chris83527/railway/README.md

# railway
Schematics for railway controller
