chris83527/railway/railway_keypad/railway_keypad.png

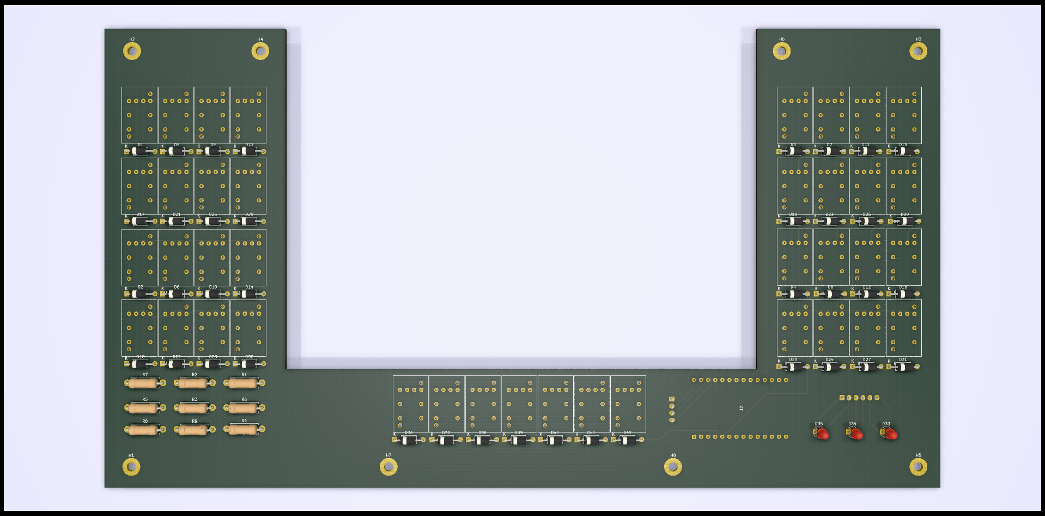
railway_keypad/railway_keypad.png
