chris83527/railway/railway/railway_back_panel2.FCStd

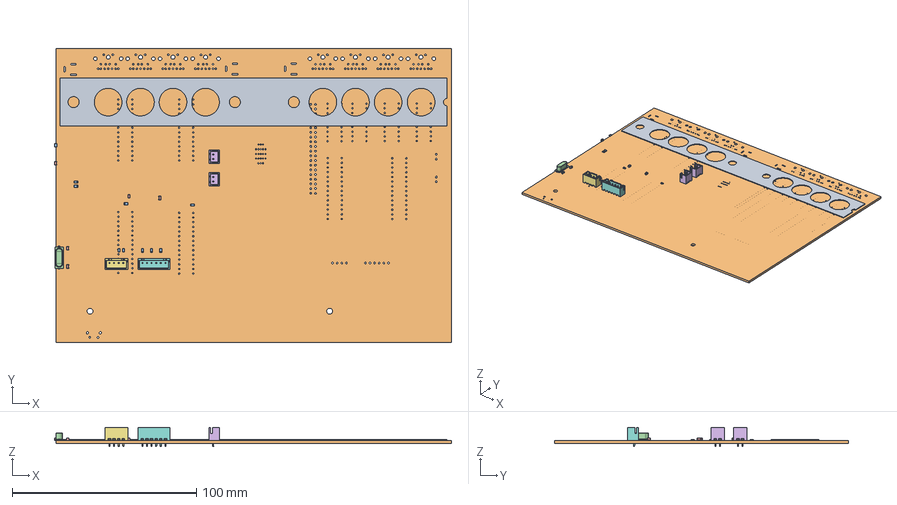
[picture p2: CAD file, 2024-12-26]
railway/railway_back_panel2.FCStd
215.4 x 159.7 x 10.4 mm
Pcb_d347
R20_R_0805_2012Metric_8b4ad0b62f5e x 10
Y1_Crystal_SMD_HC49-SD_456765e1dc0e
C9_C_0805_2012Metric_157590397889 x 5
J3_JST_B2B_XH_A_e3afbfe7dc1d x 2
J5_JST_B4B_XH_A_566c48c3f301
J2_JST_B6B_XH_A_4f16ad57375a
