chris83527/railway/railway/railway_back_panel2-Body.stl

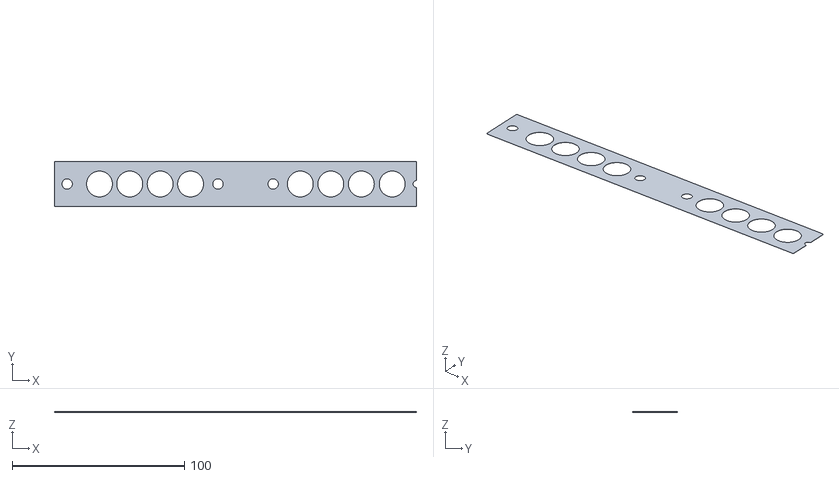
[picture p3: CAD file, 2024-12-26]
railway/railway_back_panel2-Body.stl
210.0 x 26.0 x 0.5
