chris83527/railway/railway/bezel-Body.stl

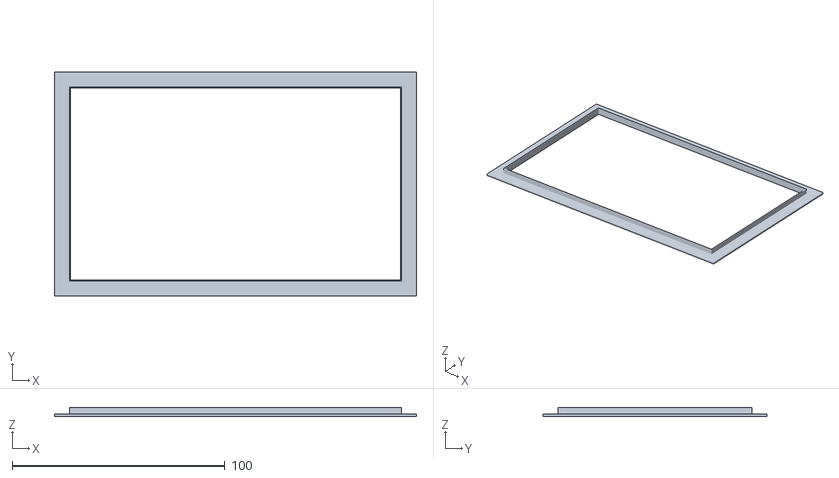
[picture p4: CAD file, 2024-12-26]
railway/bezel-Body.stl
170.0 x 105.0 x 4.00
