chris83527/railway/railway/button-Body.stl

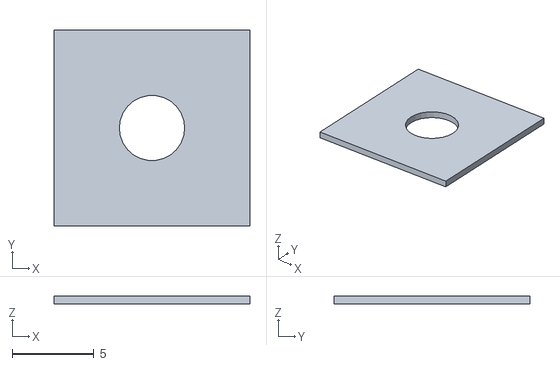
[picture p5: CAD file, 2024-12-26]
railway/button-Body.stl
12.0 x 12.0 x 0.5
