chris83527/railway/(list of files, cad)

Other CAD files:
railway/bezel.FCStd
railway/button.FCStd
