chris83527/railway/railway/plots/railway__Assembly.pdf

1 | 2 | 3 | 4 | 5 | 6 | 7 | 8

A

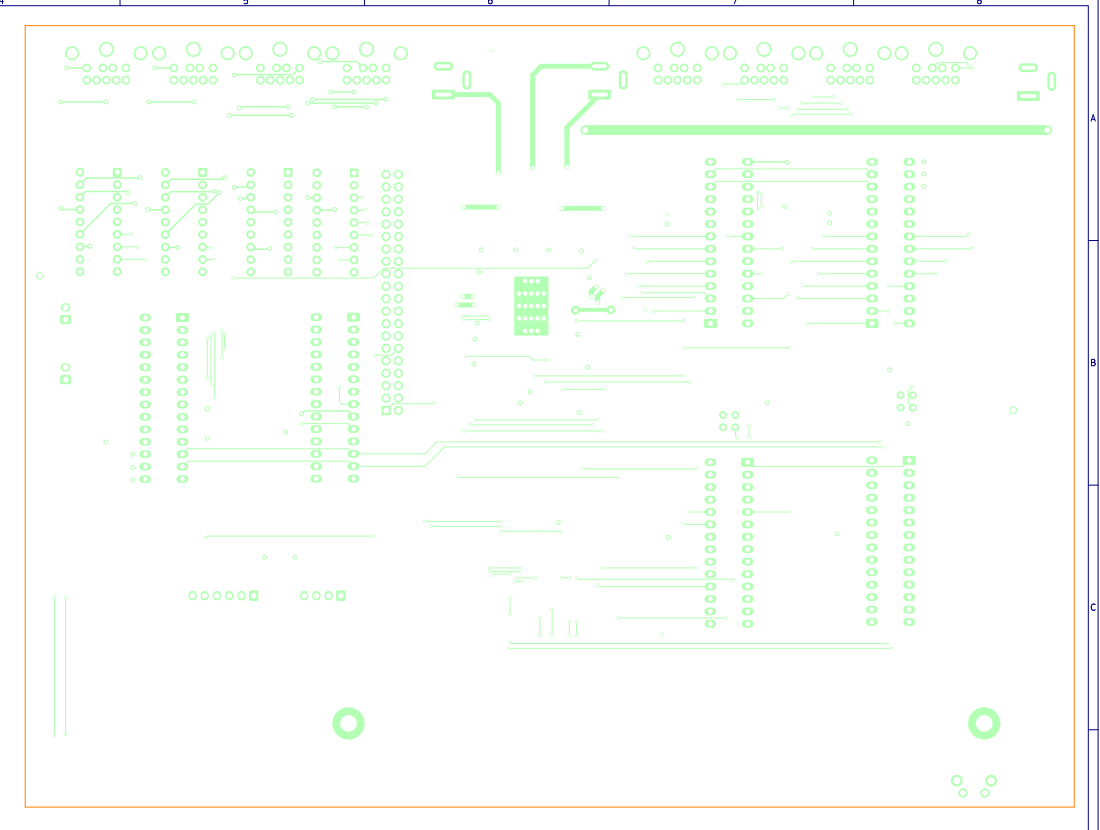
[picture p6: page 1]
F Date: 2019-11-09 KiCad; E.D.A. 8.0.6 Size: A3; Rev:

File: railway.kicad_pcb Sheet:
Id: 1/1 Title: Ray's Railway

# J5 D¹¹

A

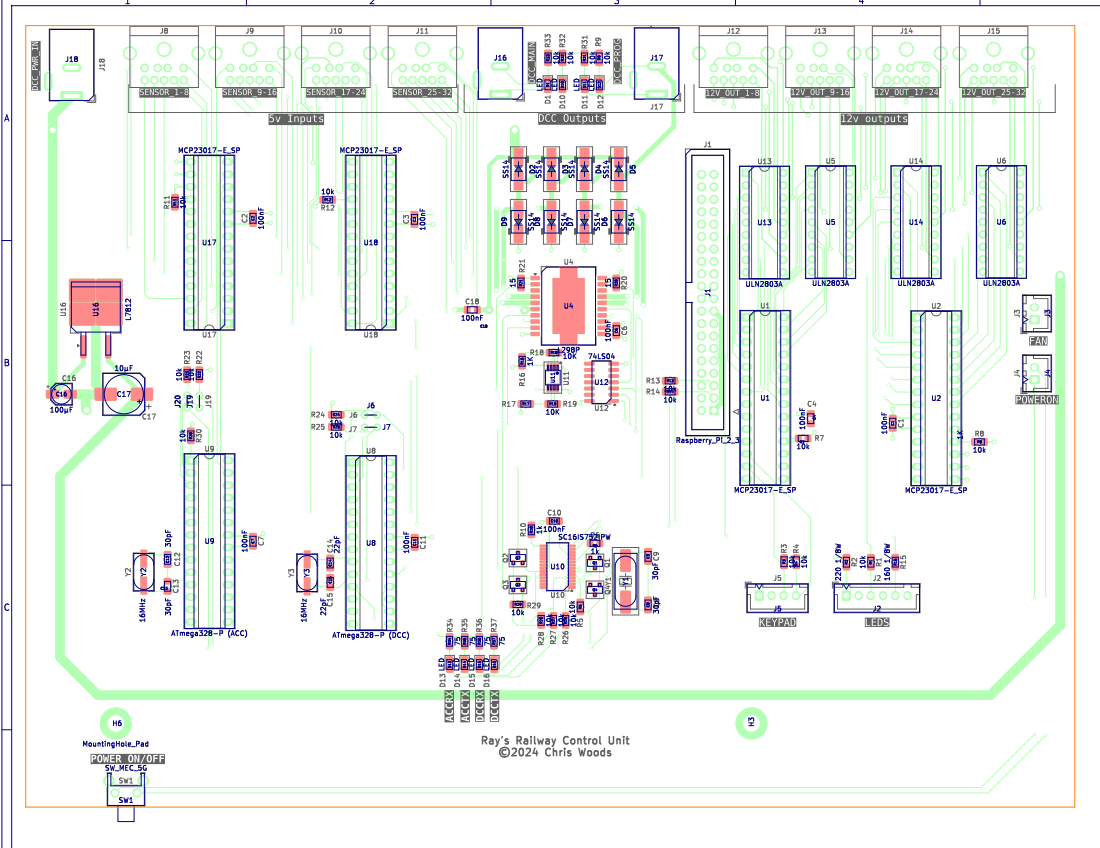
[picture p7: page 2]

File: railway.kicad_pcb Sheet: H³

# J5 D¹¹

A

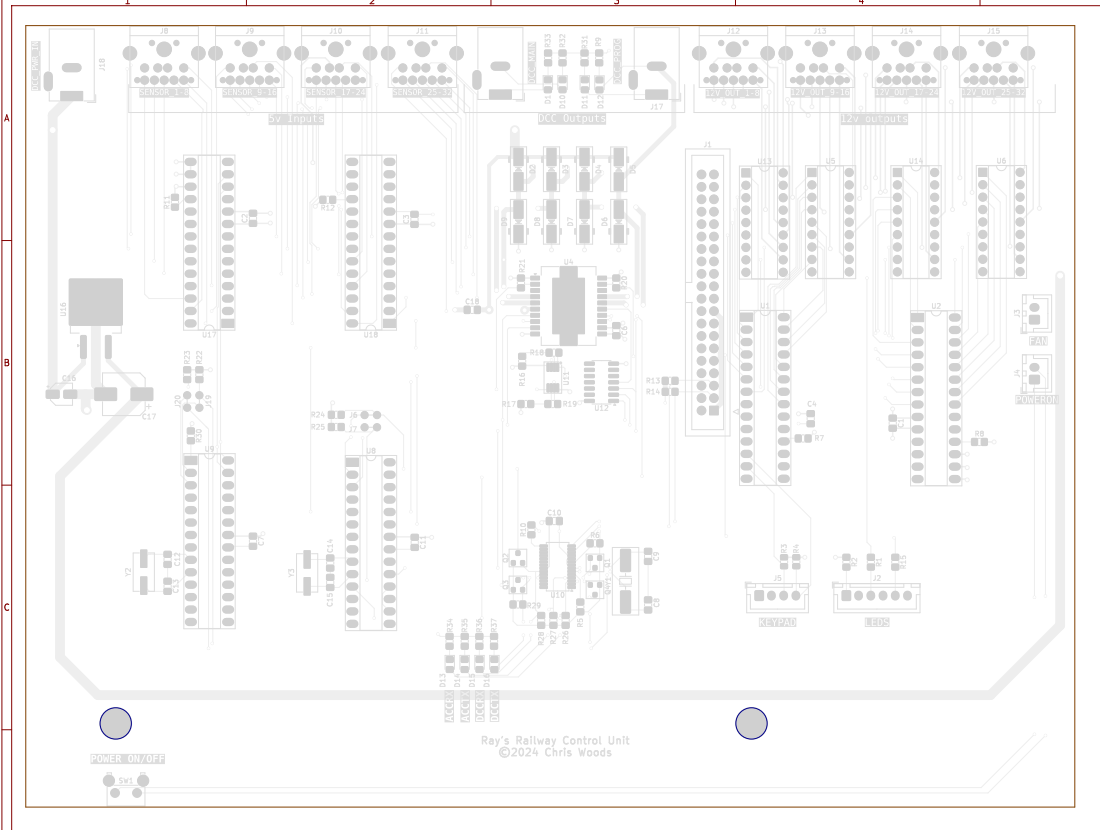
[picture p8: page 3]

A

A

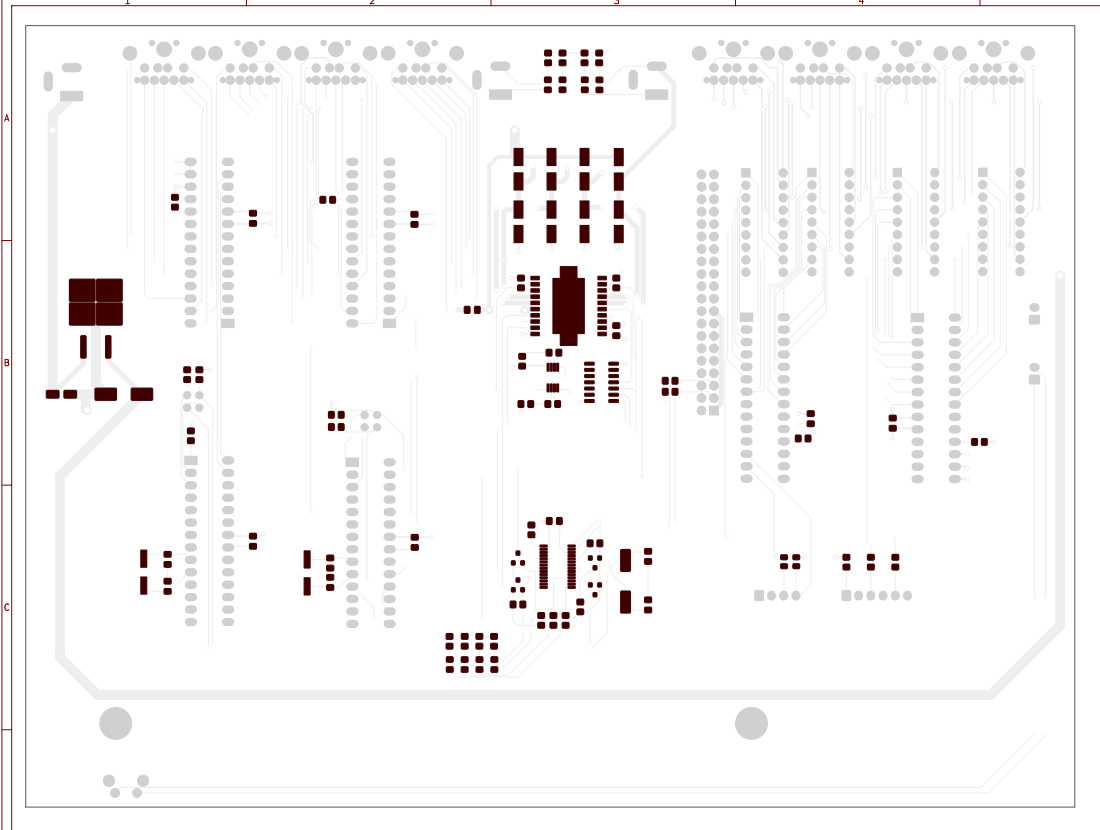
[picture p9: page 4]

File: railway.kicad_pcb Sheet:

A

A

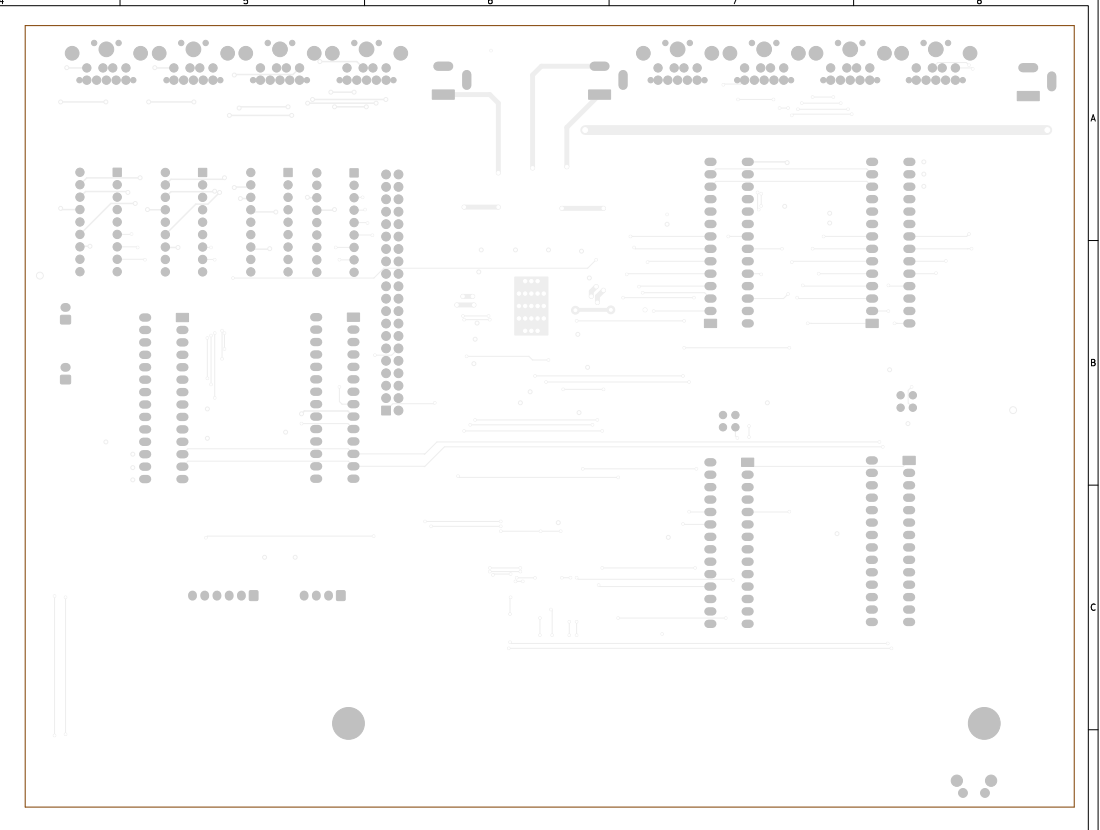
[picture p10: page 5]

File: railway.kicad_pcb Sheet:

# J5 D¹¹

# Q3 SS¹⁴ D⁶

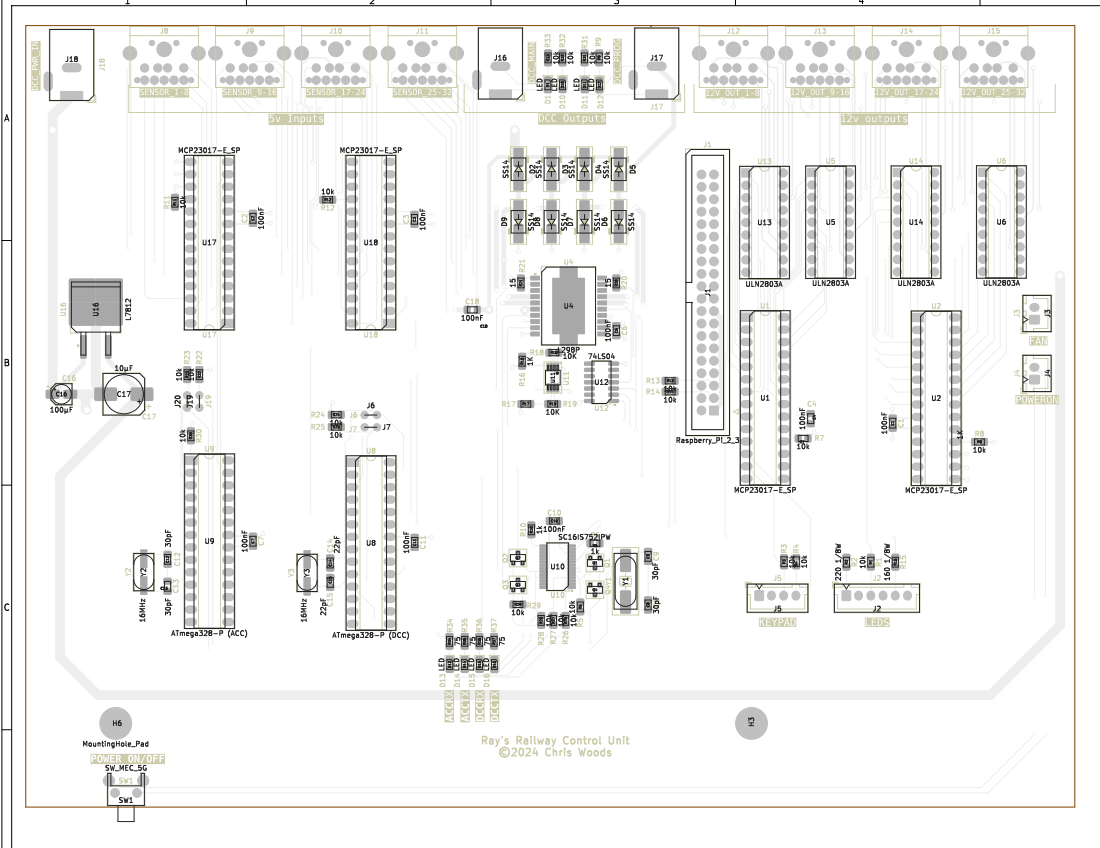
[picture p11: page 6]

A

A

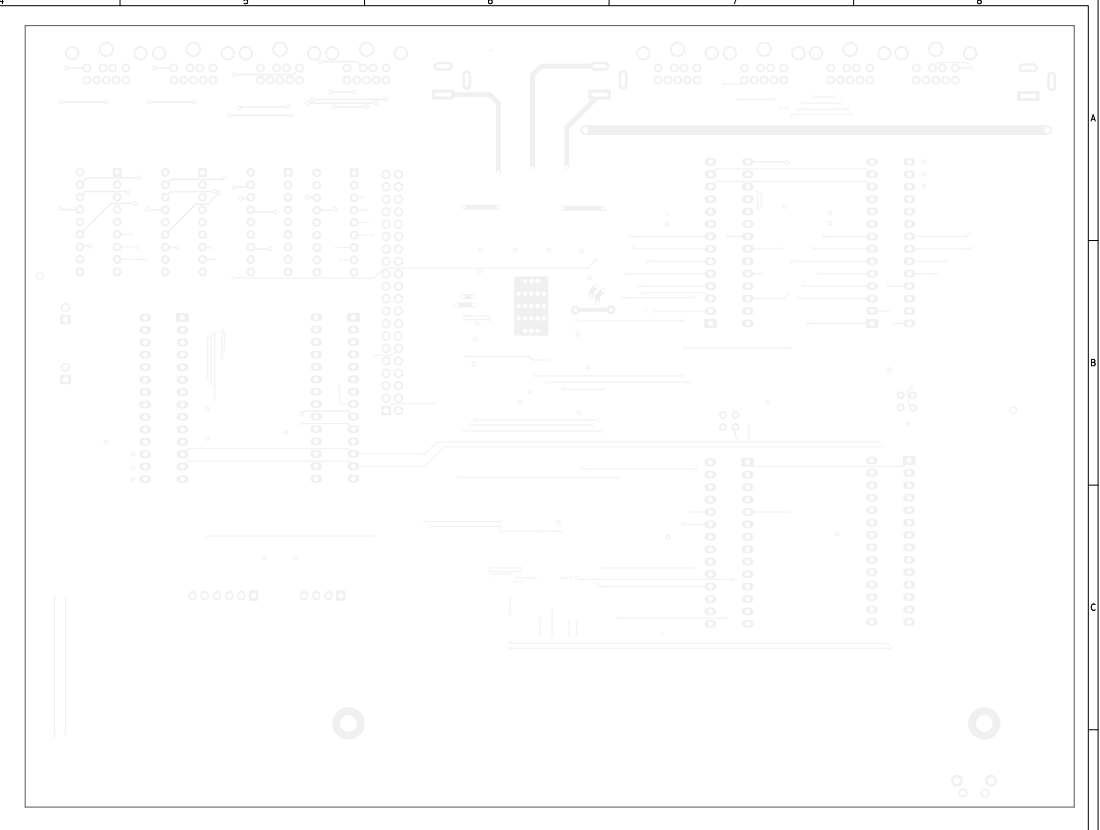
[picture p12: page 7]

File: railway.kicad_pcb Sheet:

# J5 D¹¹

A

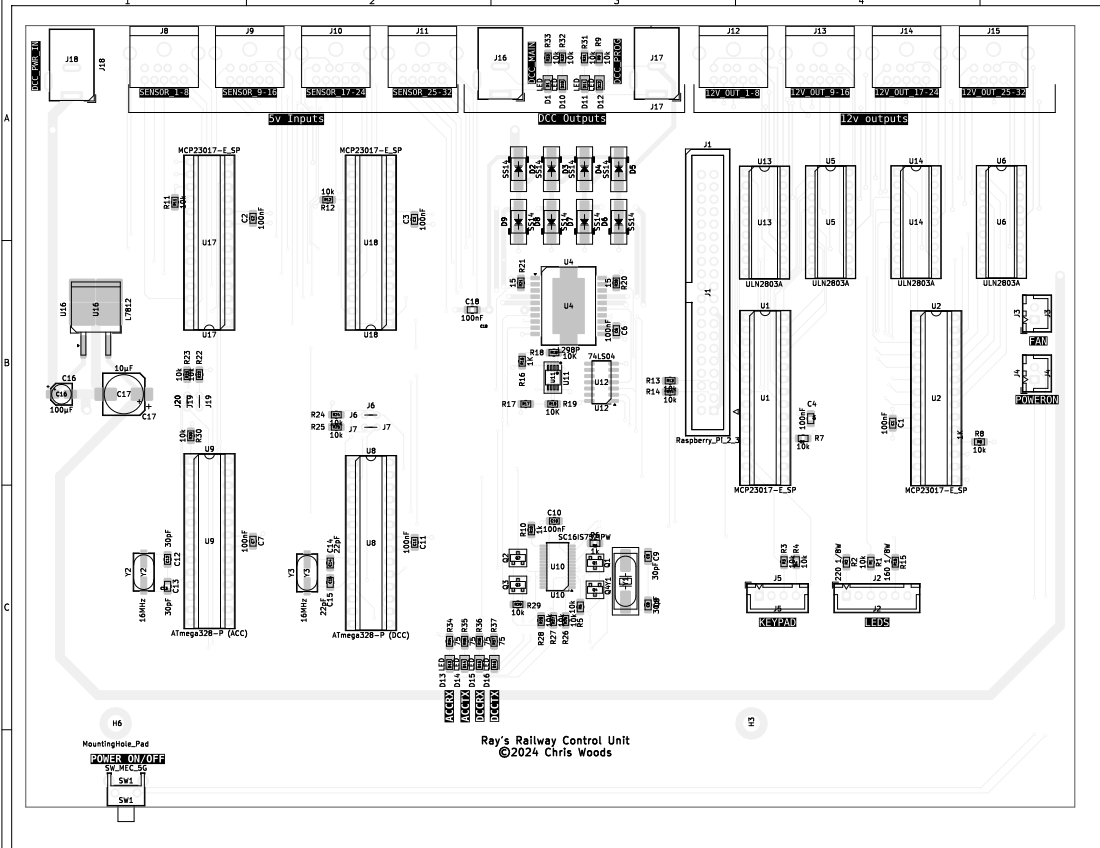
[picture p13: page 8]

File: railway.kicad_pcb Sheet: H³
