chris83527/railway/railway/railway.pdf

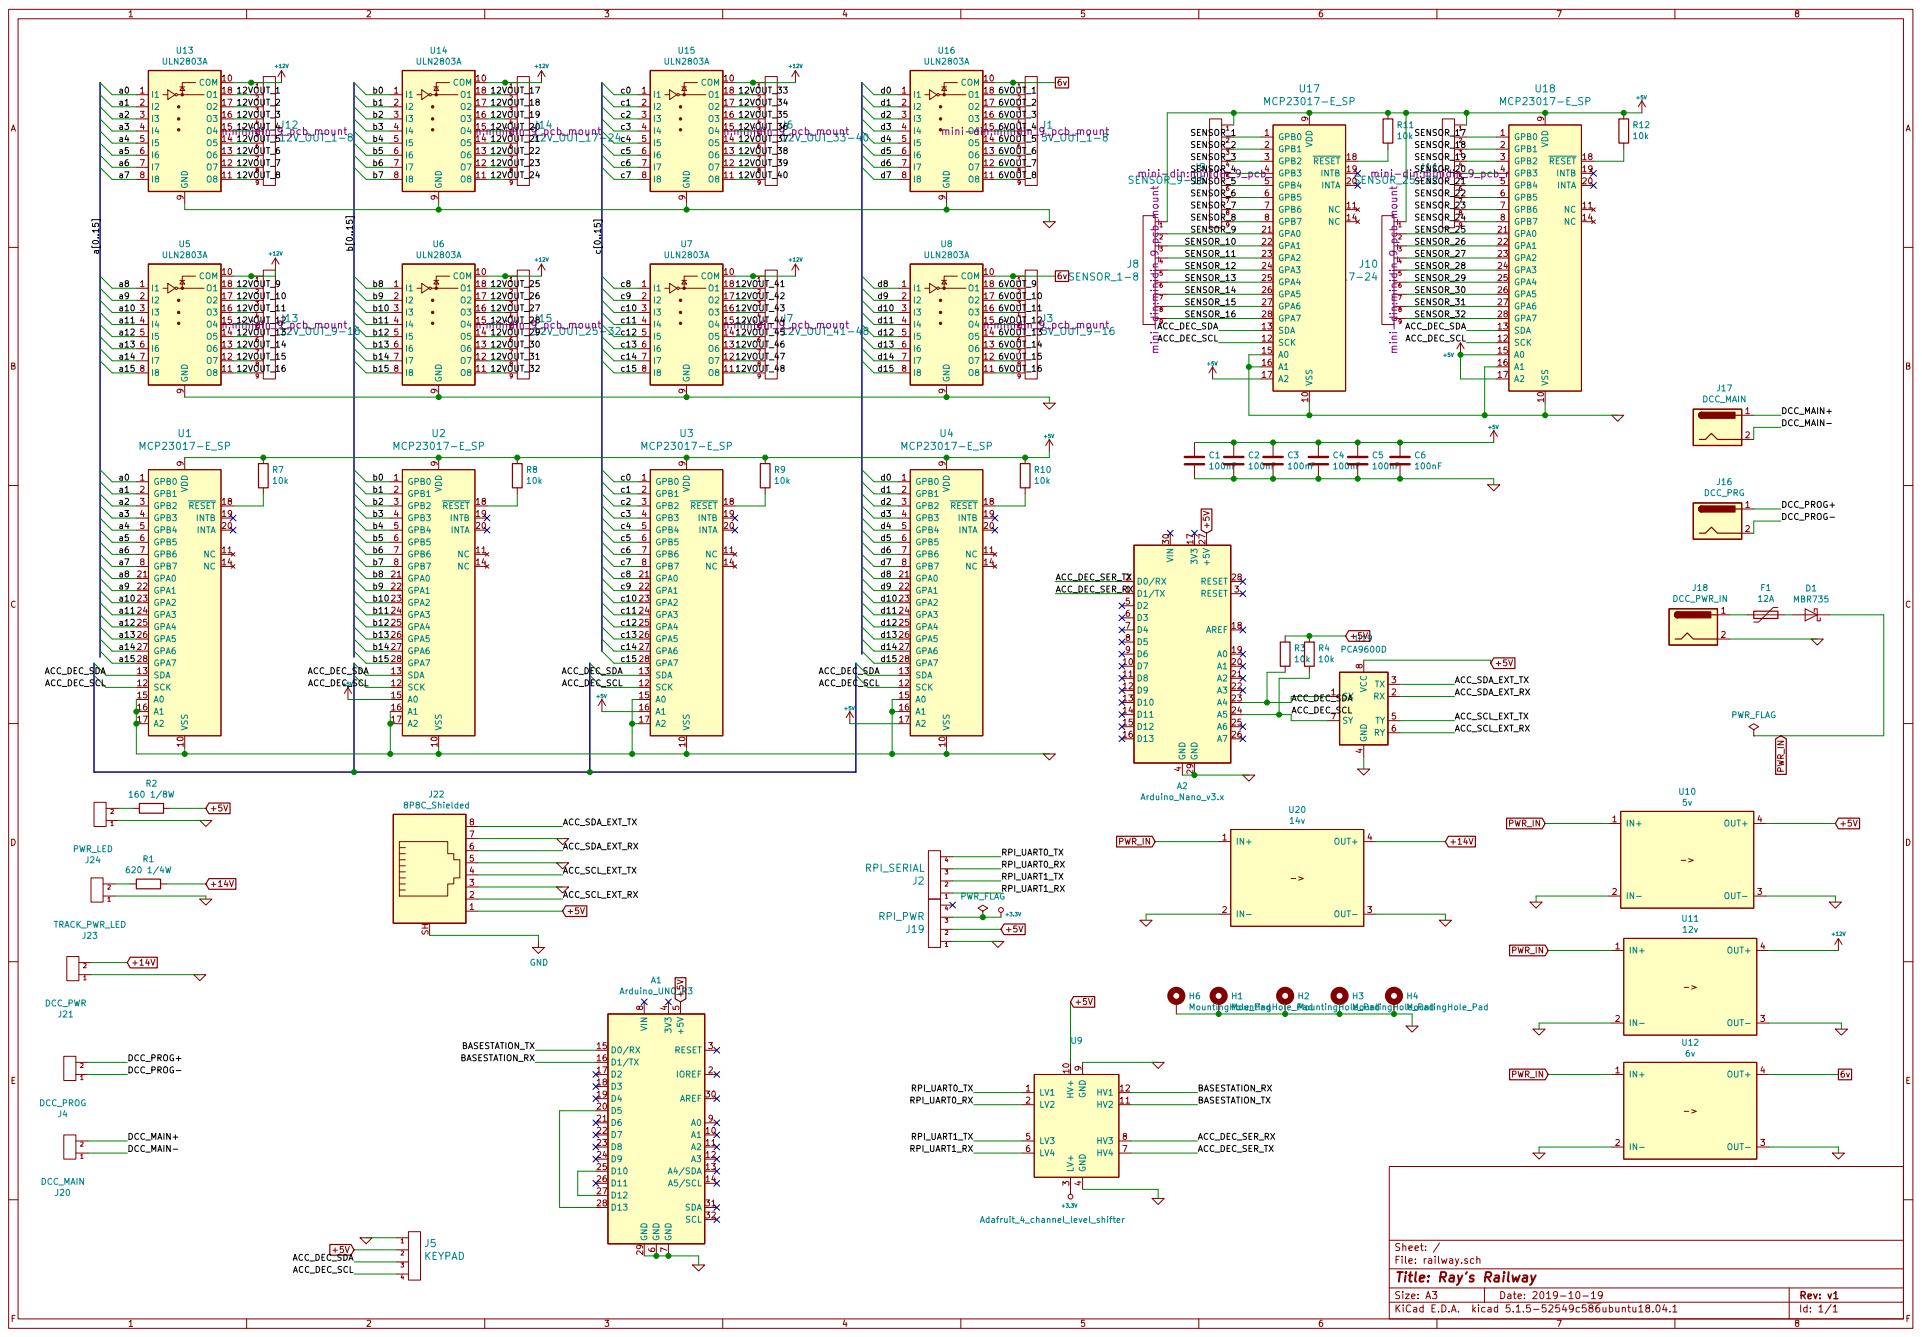
[picture p14: page 1]

9 U6 ULN2803A GPB0 1 VSS 10 NC 11 SCK 12 SDA 13 NC 14 A0 15 A1 16 A2 17 RESET 18

4 TY 5 RY 6 SY 7 VCC

9 U9 Adafruit_4_channel_level_shifter +3.3V A1 10 A2 11 A3 12 A4/SDA 13 A5/SCL 14 D0/RX 15 D1/TX 16 D2 17 D3 18 D4 19

File: railway.sch Sheet: /
Id: 1/1 Title: Ray's Railway
