chris83527/railway/railway/railway.kicad_pcb

## KiCad design railway/railway.kicad_pcb (2024-12-26)

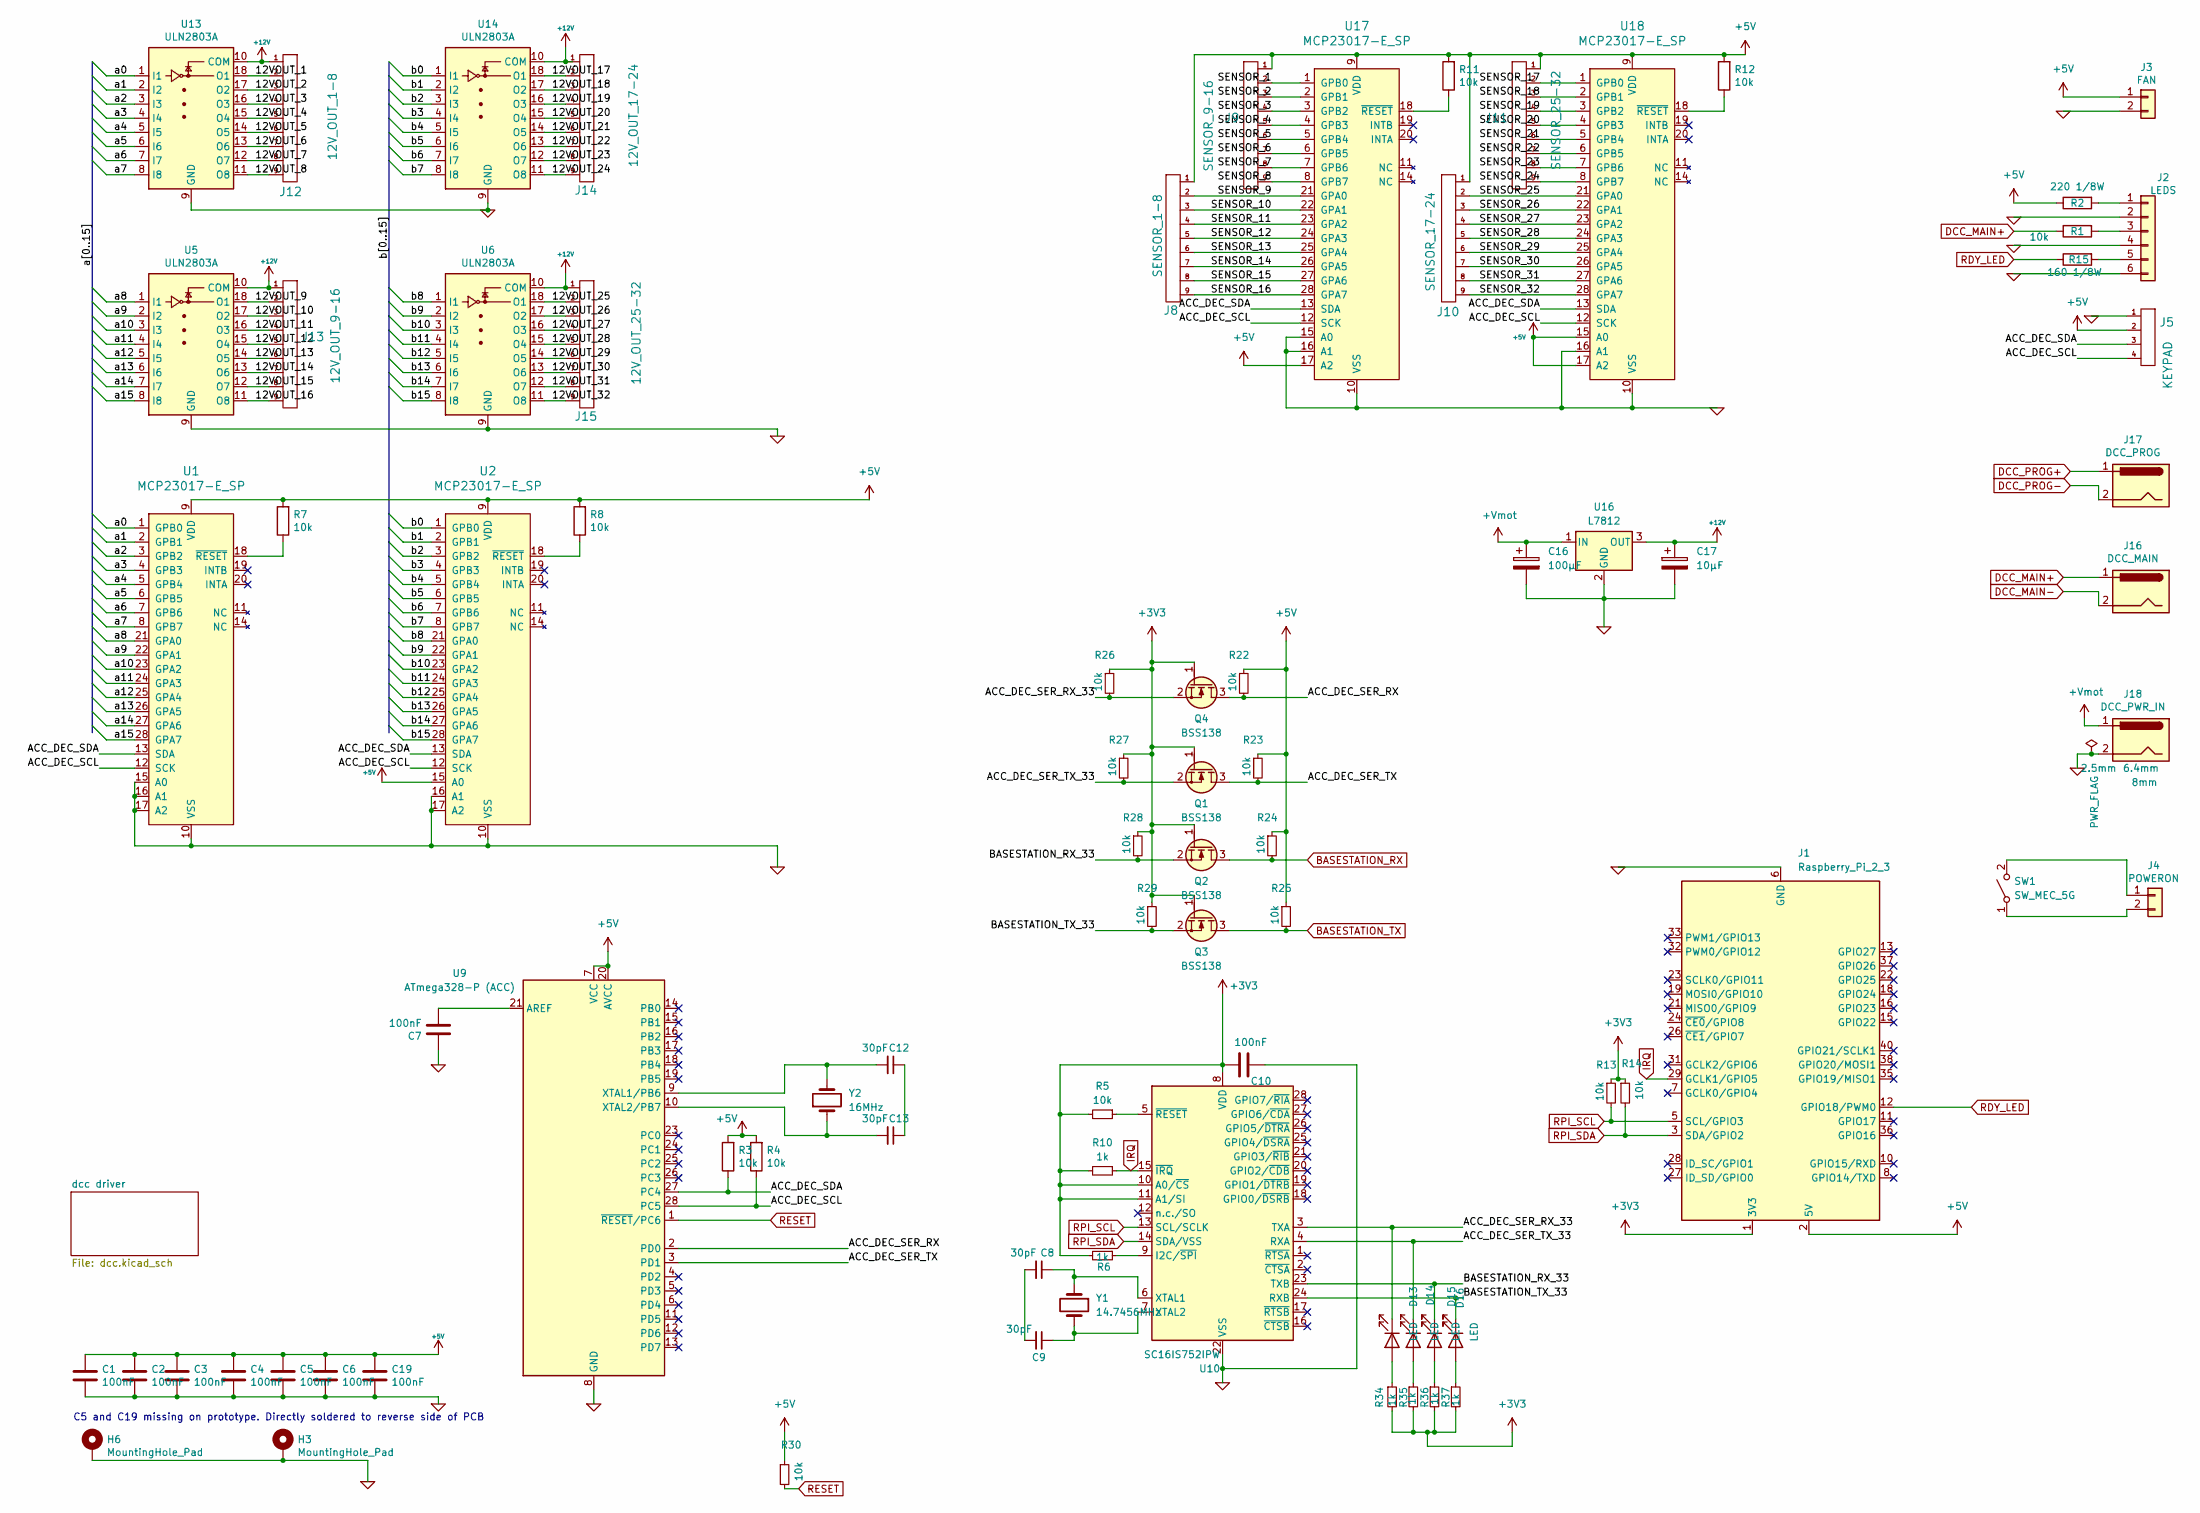
[picture p15: schematic railway.kicad_sch, Ray's Railway]

Parts:
C1, C2, C3, C4, C5, C6, C7, C10, C19: 100nF; C_0805_2012Metric_Pad1.18x1.45mm_HandSolder
C8, C9, C12, C13: 30pF; C_0805_2012Metric_Pad1.18x1.45mm_HandSolder
C16: 100µF; CP_Elec_4x4.5
C17: 10µF; CP_Elec_8x10.5
D13, D14, D15, D16: LED; LED_0805_2012Metric_Pad1.15x1.40mm_HandSolder
H3, H6: MountingHole_Pad; MountingHole_3.2mm_M3_Pad
J1: Raspberry_Pi_2_3; IDC-Header_2x20_P2.54mm_Vertical_reversed
J2: LEDS; JST_XH_B6B-XH-A_1x06_P2.50mm_Vertical
J3: FAN; JST_XH_B2B-XH-A_1x02_P2.50mm_Vertical
J4: POWERON; JST_XH_B2B-XH-A_1x02_P2.50mm_Vertical
J5: KEYPAD; JST_XH_B4B-XH-A_1x04_P2.50mm_Vertical
J8: SENSOR_1-8; minidin_9_pcb_mount
J9: SENSOR_9-16; minidin_9_pcb_mount
J10: SENSOR_17-24; minidin_9_pcb_mount
J11: SENSOR_25-32; minidin_9_pcb_mount
J12: 12V_OUT_1-8; minidin_9_pcb_mount
J13: 12V_OUT_9-16; minidin_9_pcb_mount
J14: 12V_OUT_17-24; minidin_9_pcb_mount
J15: 12V_OUT_25-32; minidin_9_pcb_mount
J16: DCC_MAIN; BarrelJack_Wuerth_6941xx301002
J17: DCC_PROG; BarrelJack_Wuerth_6941xx301002
J18: DCC_PWR_IN; BarrelJack_Wuerth_6941xx301002
Q1, Q2, Q3, Q4: BSS138; SOT-23
R1, R5, R7, R8, R11, R12, R13, R14, R22, R23, R24, R25, R26, R27, R28, R29, R30: 10k; R_0805_2012Metric_Pad1.20x1.40mm_HandSolder
R2: 220 1/8W; R_0805_2012Metric_Pad1.20x1.40mm_HandSolder
R3, R4: 10k; R_0805_2012Metric
R6, R10, R34, R35, R36, R37: 1k; R_0805_2012Metric_Pad1.20x1.40mm_HandSolder
R15: 160 1/8W; R_0805_2012Metric_Pad1.20x1.40mm_HandSolder
SW1: SW_MEC_5G; SW_Tactile_SKHH_Angled
U1, U2, U17, U18: MCP23017-E_SP; DIP-28_W7.62mm_Socket_LongPads; MPN MCP23017-E/SP; Digi-Key_PN MCP23017-E/SP-ND
U5, U6, U13, U14: ULN2803A; DIP-18_W7.62mm_Socket
U9: ATmega328-P (ACC); DIP-28_W7.62mm_Socket_LongPads
U10: SC16IS752IPW; TSSOP-28_4.4x9.7mm_P0.65mm
U16: L7812; TO-263-2
Y1: 14.7456MHz; Crystal_SMD_HC49-SD
Y2: 16MHz; Crystal_SMD_ECS_CSM3X-2Pin_7.6x4.1mm

Connections:
+3V3: C10.2, J1.1 (3V3), J1.17 (3V3), Q1.1 (G), Q2.1 (G), Q3.1 (G), Q4.1 (G), R5.2, R6.2, R10.2, R13.1, R14.1, R26.1, R27.1, R28.1, R29.1, R34.2, R35.2, R36.2, R37.2, U10.8 (VDD), U10.10 (A0/~CS), U10.11 (A1/SI)
+5V: C1.1, C2.1, C3.1, C4.1, C5.1, C6.1, C19.1, J1.2 (5V), J1.4 (5V), J3.1, J5.2, J8.1, J9.1, J10.1, J11.1, R2.1, R3.2, R4.2, R7.2, R8.2, R11.2, R12.2, R22.1, R23.1, R24.1, R25.1, R30.1, U1.9 (VDD), U2.9 (VDD), U2.15 (A0), U9.7 (VCC), U9.20 (AVCC), U17.9 (VDD), U17.17 (A2), U18.9 (VDD), U18.15 (A0), U18.17 (A2); also elsewhere on the board
+12V: C17.1, J12.1, J13.1, J14.1, J15.1, U5.10 (COM), U6.10 (COM), U13.10 (COM), U14.10 (COM), U16.3 (OUT)
+Vmot: C16.1, J18.1, U16.1 (IN); also elsewhere on the board
/12VOUT_1: J12.2, U13.18 (O1)
/12VOUT_2: J12.3, U13.17 (O2)
/12VOUT_3: J12.4, U13.16 (O3)
/12VOUT_4: J12.5, U13.15 (O4)
/12VOUT_5: J12.6, U13.14 (O5)
/12VOUT_6: J12.7, U13.13 (O6)
/12VOUT_7: J12.8, U13.12 (O7)
/12VOUT_8: J12.9, U13.11 (O8)
/12VOUT_9: J13.2, U5.18 (O1)
/12VOUT_10: J13.3, U5.17 (O2)
/12VOUT_11: J13.4, U5.16 (O3)
/12VOUT_12: J13.5, U5.15 (O4)
/12VOUT_13: J13.6, U5.14 (O5)
/12VOUT_14: J13.7, U5.13 (O6)
/12VOUT_15: J13.8, U5.12 (O7)
/12VOUT_16: J13.9, U5.11 (O8)
/12VOUT_17: J14.2, U14.18 (O1)
/12VOUT_18: J14.3, U14.17 (O2)
/12VOUT_19: J14.4, U14.16 (O3)
/12VOUT_20: J14.5, U14.15 (O4)
/12VOUT_21: J14.6, U14.14 (O5)
/12VOUT_22: J14.7, U14.13 (O6)
/12VOUT_23: J14.8, U14.12 (O7)
/12VOUT_24: J14.9, U14.11 (O8)
/12VOUT_25: J15.2, U6.18 (O1)
/12VOUT_26: J15.3, U6.17 (O2)
/12VOUT_27: J15.4, U6.16 (O3)
/12VOUT_28: J15.5, U6.15 (O4)
/12VOUT_29: J15.6, U6.14 (O5)
/12VOUT_30: J15.7, U6.13 (O6)
/12VOUT_31: J15.8, U6.12 (O7)
/12VOUT_32: J15.9, U6.11 (O8)
/ACC_DEC_SCL: J5.4, R4.1, U1.12 (SCK), U2.12 (SCK), U9.28 (PC5), U17.12 (SCK), U18.12 (SCK)
/ACC_DEC_SDA: J5.3, R3.1, U1.13 (SDA), U2.13 (SDA), U9.27 (PC4), U17.13 (SDA), U18.13 (SDA)
/ACC_DEC_SER_RX: Q4.3 (D), R22.2, U9.2 (PD0)
/ACC_DEC_SER_RX_33: D13.1 (K), Q4.2 (S), R26.2, U10.3 (TXA)
/ACC_DEC_SER_TX: Q1.3 (D), R23.2, U9.3 (PD1)
/ACC_DEC_SER_TX_33: D14.1 (K), Q1.2 (S), R27.2, U10.4 (RXA)
/BASESTATION_RX_33: D15.1 (K), Q2.2 (S), R28.2, U10.23 (TXB)
/BASESTATION_TX_33: D16.1 (K), Q3.2 (S), R29.2, U10.24 (RXB)
/SENSOR_1: J9.2, U17.1 (GPB0)
/SENSOR_2: J9.3, U17.2 (GPB1)
/SENSOR_3: J9.4, U17.3 (GPB2)
/SENSOR_4: J9.5, U17.4 (GPB3)
/SENSOR_5: J9.6, U17.5 (GPB4)
/SENSOR_6: J9.7, U17.6 (GPB5)
/SENSOR_7: J9.8, U17.7 (GPB6)
/SENSOR_8: J9.9, U17.8 (GPB7)
/SENSOR_9: J8.2, U17.21 (GPA0)
/SENSOR_10: J8.3, U17.22 (GPA1)
/SENSOR_11: J8.4, U17.23 (GPA2)
/SENSOR_12: J8.5, U17.24 (GPA3)
/SENSOR_13: J8.6, U17.25 (GPA4)
/SENSOR_14: J8.7, U17.26 (GPA5)
/SENSOR_15: J8.8, U17.27 (GPA6)
/SENSOR_16: J8.9, U17.28 (GPA7)
/SENSOR_17: J11.2, U18.1 (GPB0)
/SENSOR_18: J11.3, U18.2 (GPB1)
/SENSOR_19: J11.4, U18.3 (GPB2)
/SENSOR_20: J11.5, U18.4 (GPB3)
/SENSOR_21: J11.6, U18.5 (GPB4)
/SENSOR_22: J11.7, U18.6 (GPB5)
/SENSOR_23: J11.8, U18.7 (GPB6)
/SENSOR_24: J11.9, U18.8 (GPB7)
/SENSOR_25: J10.2, U18.21 (GPA0)
/SENSOR_26: J10.3, U18.22 (GPA1)
/SENSOR_27: J10.4, U18.23 (GPA2)
/SENSOR_28: J10.5, U18.24 (GPA3)
/SENSOR_29: J10.6, U18.25 (GPA4)
/SENSOR_30: J10.7, U18.26 (GPA5)
/SENSOR_31: J10.8, U18.27 (GPA6)
/SENSOR_32: J10.9, U18.28 (GPA7)
/a0: U1.1 (GPB0), U13.1 (I1)
/a1: U1.2 (GPB1), U13.2 (I2)
/a2: U1.3 (GPB2), U13.3 (I3)
/a3: U1.4 (GPB3), U13.4 (I4)
/a4: U1.5 (GPB4), U13.5 (I5)
/a5: U1.6 (GPB5), U13.6 (I6)
/a6: U1.7 (GPB6), U13.7 (I7)
/a7: U1.8 (GPB7), U13.8 (I8)
/a8: U1.21 (GPA0), U5.1 (I1)
/a9: U1.22 (GPA1), U5.2 (I2)
/a10: U1.23 (GPA2), U5.3 (I3)
/a11: U1.24 (GPA3), U5.4 (I4)
/a12: U1.25 (GPA4), U5.5 (I5)
/a13: U1.26 (GPA5), U5.6 (I6)
/a14: U1.27 (GPA6), U5.7 (I7)
/a15: U1.28 (GPA7), U5.8 (I8)
/b0: U2.1 (GPB0), U14.1 (I1)
/b1: U2.2 (GPB1), U14.2 (I2)
/b2: U2.3 (GPB2), U14.3 (I3)
/b3: U2.4 (GPB3), U14.4 (I4)
/b4: U2.5 (GPB4), U14.5 (I5)
/b5: U2.6 (GPB5), U14.6 (I6)
/b6: U2.7 (GPB6), U14.7 (I7)
/b7: U2.8 (GPB7), U14.8 (I8)
/b8: U2.21 (GPA0), U6.1 (I1)
/b9: U2.22 (GPA1), U6.2 (I2)
/b10: U2.23 (GPA2), U6.3 (I3)
/b11: U2.24 (GPA3), U6.4 (I4)
/b12: U2.25 (GPA4), U6.5 (I5)
/b13: U2.26 (GPA5), U6.6 (I6)
/b14: U2.27 (GPA6), U6.7 (I7)
/b15: U2.28 (GPA7), U6.8 (I8)
BASESTATION_RX: Q2.3 (D), R24.2; also elsewhere on the board
BASESTATION_TX: Q3.3 (D), R25.2; also elsewhere on the board
DCC_MAIN+: J16.1, R1.1; also elsewhere on the board
DCC_MAIN-: J16.2; also elsewhere on the board
DCC_PROG+: J17.1; also elsewhere on the board
DCC_PROG-: J17.2; also elsewhere on the board
GND: C1.2, C2.2, C3.2, C4.2, C5.2, C6.2, C7.1, C10.1, C16.2, C17.2, C19.2, H3.1, H6.1, J1.6 (GND), J1.9 (GND), J1.14 (GND), J1.20 (GND), J1.25 (GND), J1.30 (GND), J1.34 (GND), J1.39 (GND), J2.2, J2.4, J2.6, J3.2, J5.1, J18.2, U1.10 (VSS), U1.15 (A0), U1.16 (A1), U1.17 (A2), U2.10 (VSS), U2.16 (A1), U2.17 (A2), U5.9 (GND), U6.9 (GND), U9.8 (GND), U9.22 (GND), U10.22 (VSS), U13.9 (GND), U14.9 (GND), U16.2 (GND), U17.10 (VSS), U17.15 (A0), U17.16 (A1), U18.10 (VSS), U18.16 (A1); also elsewhere on the board
IRQ: J1.29 (GCLK1/GPIO5), R10.1, U10.15 (~IRQ)
unnamed: C8.2, C9.2
unnamed: C12.1, C13.1
unnamed: D13.2 (A), R34.1
unnamed: D14.2 (A), R35.1
unnamed: D15.2 (A), R36.1
unnamed: D16.2 (A), R37.1
unnamed: J2.1, R2.2
unnamed: J2.3, R1.2
unnamed: J2.5, R15.2
unnamed: J4.1, SW1.2 (B)
unnamed: J4.2, SW1.1 (A)
unnamed: R7.1, U1.18 (~RESET)
unnamed: R8.1, U2.18 (~RESET)
unnamed: C7.2, U9.21 (AREF)
unnamed: C12.2, U9.9 (XTAL1/PB6), Y2.2
unnamed: C13.2, U9.10 (XTAL2/PB7), Y2.1
unnamed: R6.1, U10.9 (I2C/~SPI)
unnamed: C8.1, U10.6 (XTAL1), Y1.1
unnamed: C9.1, U10.7 (XTAL2), Y1.2
unnamed: R5.1, U10.5 (~RESET)
unnamed: R11.1, U17.18 (~RESET)
unnamed: R12.1, U18.18 (~RESET)
RDY_LED: J1.12 (GPIO18/PWM0), R15.1
RESET: R30.2, U9.1 (~RESET/PC6); also elsewhere on the board
RPI_SCL: J1.5 (SCL/GPIO3), R13.2, U10.13 (SCL/SCLK)
RPI_SDA: J1.3 (SDA/GPIO2), R14.2, U10.14 (SDA/VSS)

Notes on the sheet:
C5 and C19 missing on prototype. Directly soldered to reverse side of PCB

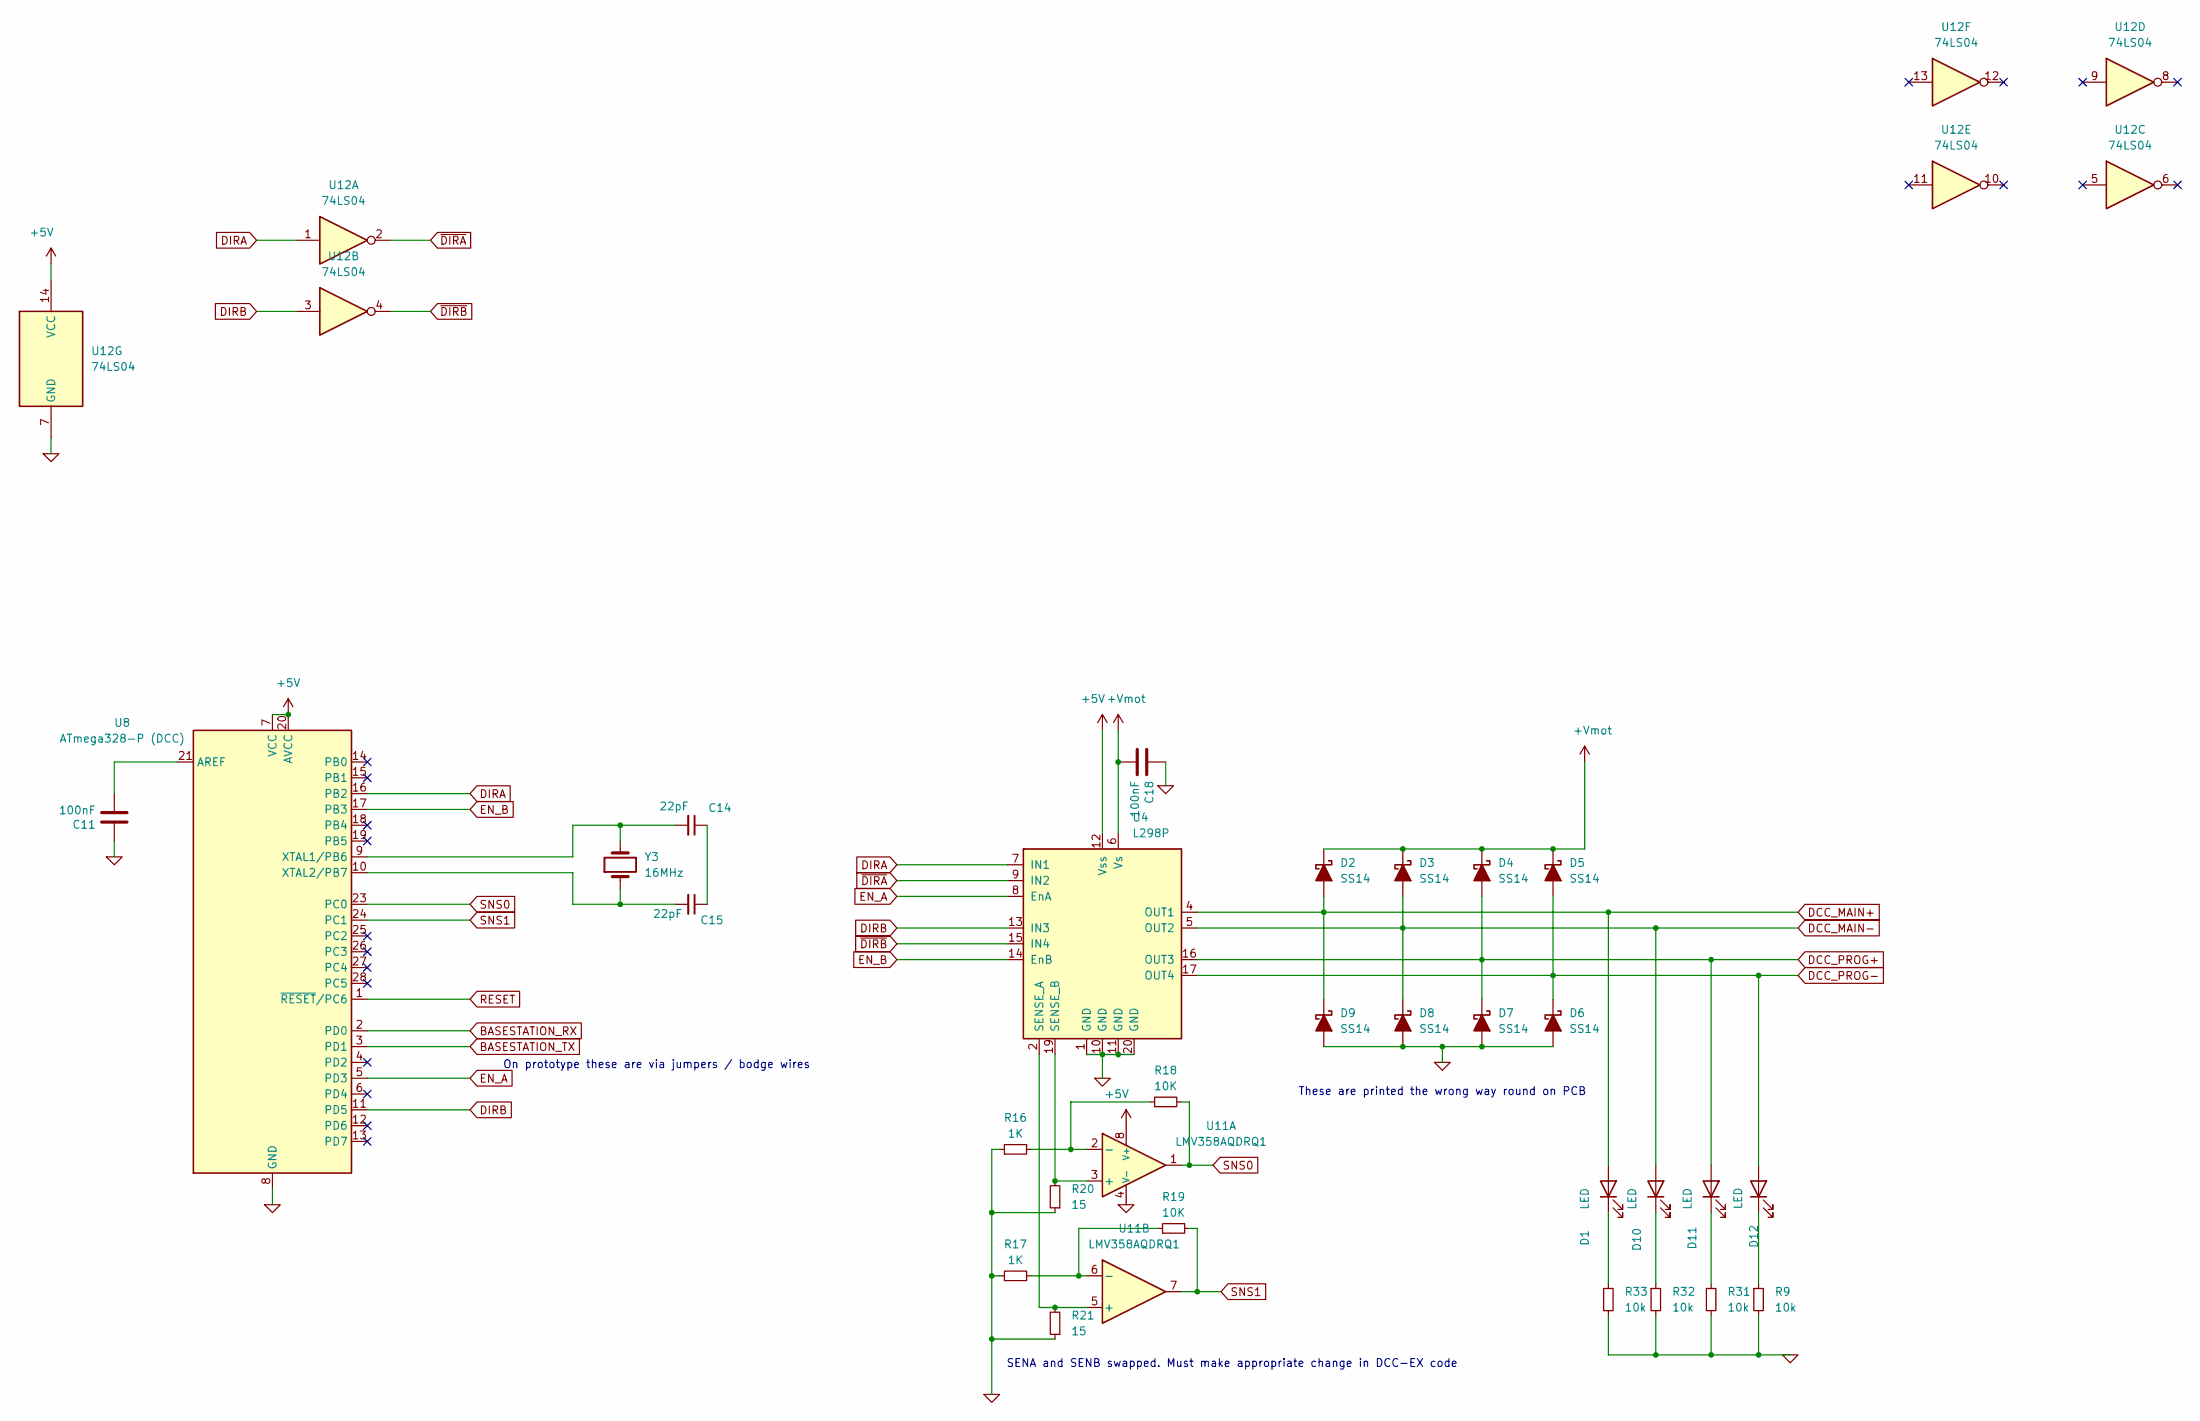
[picture p16: schematic dcc.kicad_sch]

Parts:
C11, C18: 100nF; C_0805_2012Metric_Pad1.18x1.45mm_HandSolder
C14, C15: 22pF; C_0805_2012Metric_Pad1.18x1.45mm_HandSolder
D1, D10, D11, D12: LED; LED_0805_2012Metric_Pad1.15x1.40mm_HandSolder
D2, D3, D4, D5, D6, D7, D8, D9: SS14; D_SMA_Handsoldering
R9, R31, R32, R33: 10k; R_0805_2012Metric_Pad1.20x1.40mm_HandSolder
R16, R17: 1K; R_0805_2012Metric_Pad1.20x1.40mm_HandSolder
R18, R19: 10K; R_0805_2012Metric_Pad1.20x1.40mm_HandSolder
R20, R21: 15; R_0805_2012Metric_Pad1.20x1.40mm_HandSolder
U4: L298P; HSOP-20-1EP_11.0x15.9mm_P1.27mm_SlugDown_ThermalVias
U8: ATmega328-P (DCC); DIP-28_W7.62mm_Socket_LongPads
U11: LMV358AQDRQ1; SSOP-8_3.9x5.05mm_P1.27mm
U12: 74LS04; SOIC-14_3.9x8.7mm_P1.27mm
Y3: 16MHz; Crystal_SMD_ECS_CSM3X-2Pin_7.6x4.1mm

Connections:
+5V: U4.12 (Vss), U8.7 (VCC), U8.20 (AVCC), U11.8 (V+), U12.14 (VCC); also elsewhere on the board
+Vmot: C18.2, D2.1 (K), D3.1 (K), D4.1 (K), D5.1 (K), U4.6 (Vs); also elsewhere on the board
BASESTATION_RX: U8.2 (PD0); also elsewhere on the board
BASESTATION_TX: U8.3 (PD1); also elsewhere on the board
DCC_MAIN+: D1.2 (A), D2.2 (A), D9.1 (K), U4.4 (OUT1); also elsewhere on the board
DCC_MAIN-: D3.2 (A), D8.1 (K), D10.2 (A), U4.5 (OUT2); also elsewhere on the board
DCC_PROG+: D4.2 (A), D7.1 (K), D11.2 (A), U4.16 (OUT3); also elsewhere on the board
DCC_PROG-: D5.2 (A), D6.1 (K), D12.2 (A), U4.17 (OUT4); also elsewhere on the board
DIRA: U4.7 (IN1), U8.16 (PB2), U12.1
DIRB: U4.13 (IN3), U8.11 (PD5), U12.3
EN_A: U4.8 (EnA), U8.5 (PD3)
EN_B: U4.14 (EnB), U8.17 (PB3)
GND: C11.1, C18.1, D6.2 (A), D7.2 (A), D8.2 (A), D9.2 (A), R9.2, R16.1, R17.1, R20.1, R21.1, R31.2, R32.2, R33.2, U4.1 (GND), U4.10 (GND), U4.11 (GND), U4.20 (GND), U8.8 (GND), U8.22 (GND), U11.4 (V-), U12.7 (GND); also elsewhere on the board
unnamed: C14.1, C15.1
unnamed: D1.1 (K), R33.1
unnamed: D10.1 (K), R32.1
unnamed: D11.1 (K), R31.1
unnamed: D12.1 (K), R9.1
unnamed: C11.2, U8.21 (AREF)
unnamed: C14.2, U8.9 (XTAL1/PB6), Y3.2
unnamed: C15.2, U8.10 (XTAL2/PB7), Y3.1
unnamed: R20.2, U4.19 (SENSE_B), U11.3 (+)
unnamed: R16.2, R18.1, U11.2 (-)
unnamed: R21.2, U4.2 (SENSE_A), U11.5 (+)
unnamed: R17.2, R19.1, U11.6 (-)
RESET: U8.1 (~RESET/PC6); also elsewhere on the board
SNS0: R18.2, U8.23 (PC0), U11.1
SNS1: R19.2, U8.24 (PC1), U11.7
~DIRA: U4.9 (IN2), U12.2
~DIRB: U4.15 (IN4), U12.4

Notes on the sheet:
On prototype these are via jumpers / bodge wires
SENA and SENB swapped. Must make appropriate change in DCC-EX code
These are printed the wrong way round on PCB

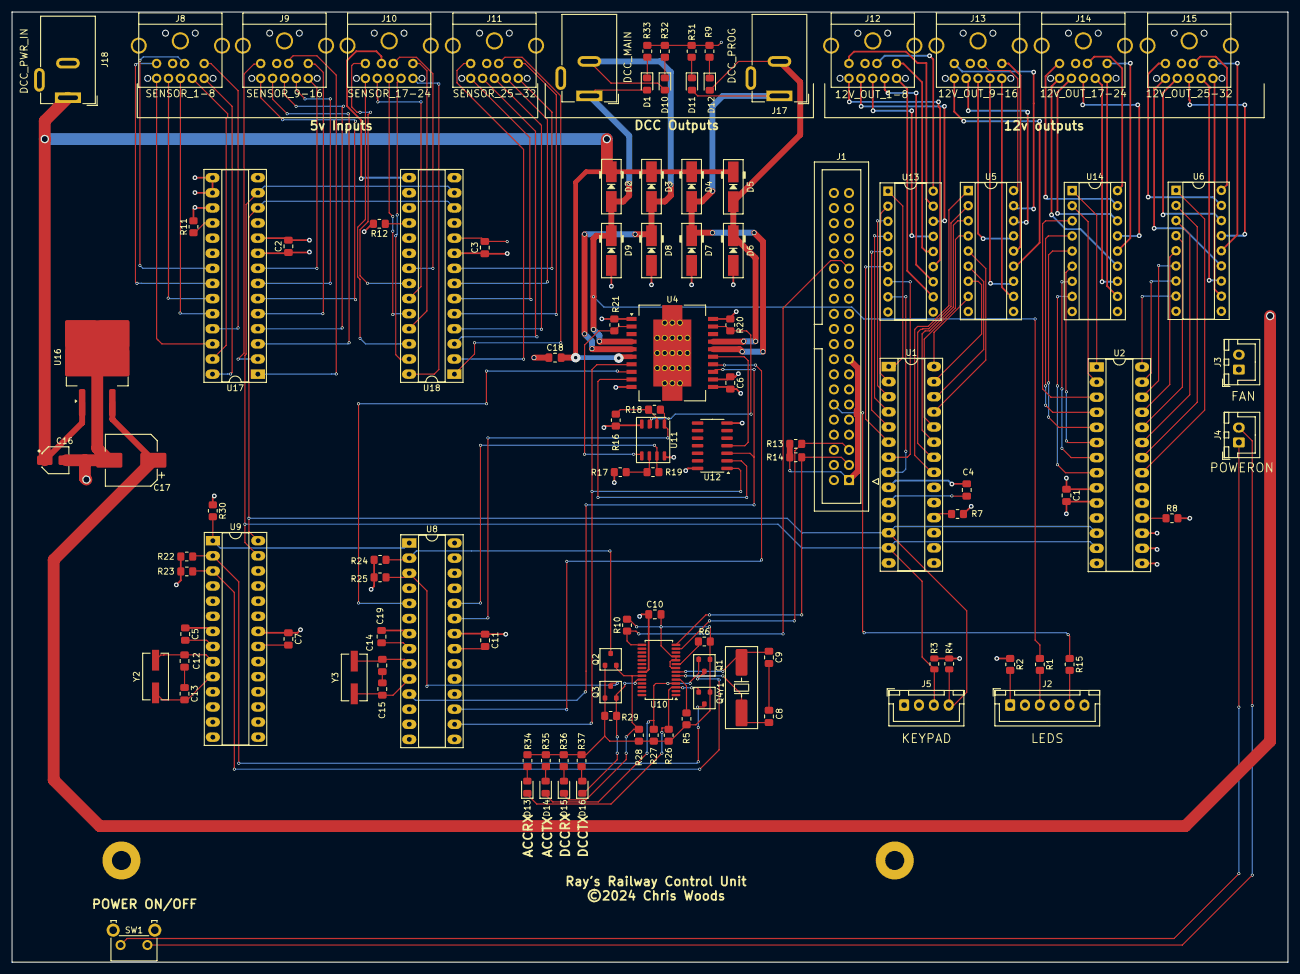
[picture p17: board railway.kicad_pcb from above]

Board: 4 copper layers, 214.5 x 159.7 mm, 113 parts (0 on the bottom side), 162 nets.
