chris83527/railway/railway_keypad/railway_keypad.kicad_pcb

## KiCad design railway_keypad/railway_keypad.kicad_pcb (2024-12-26)

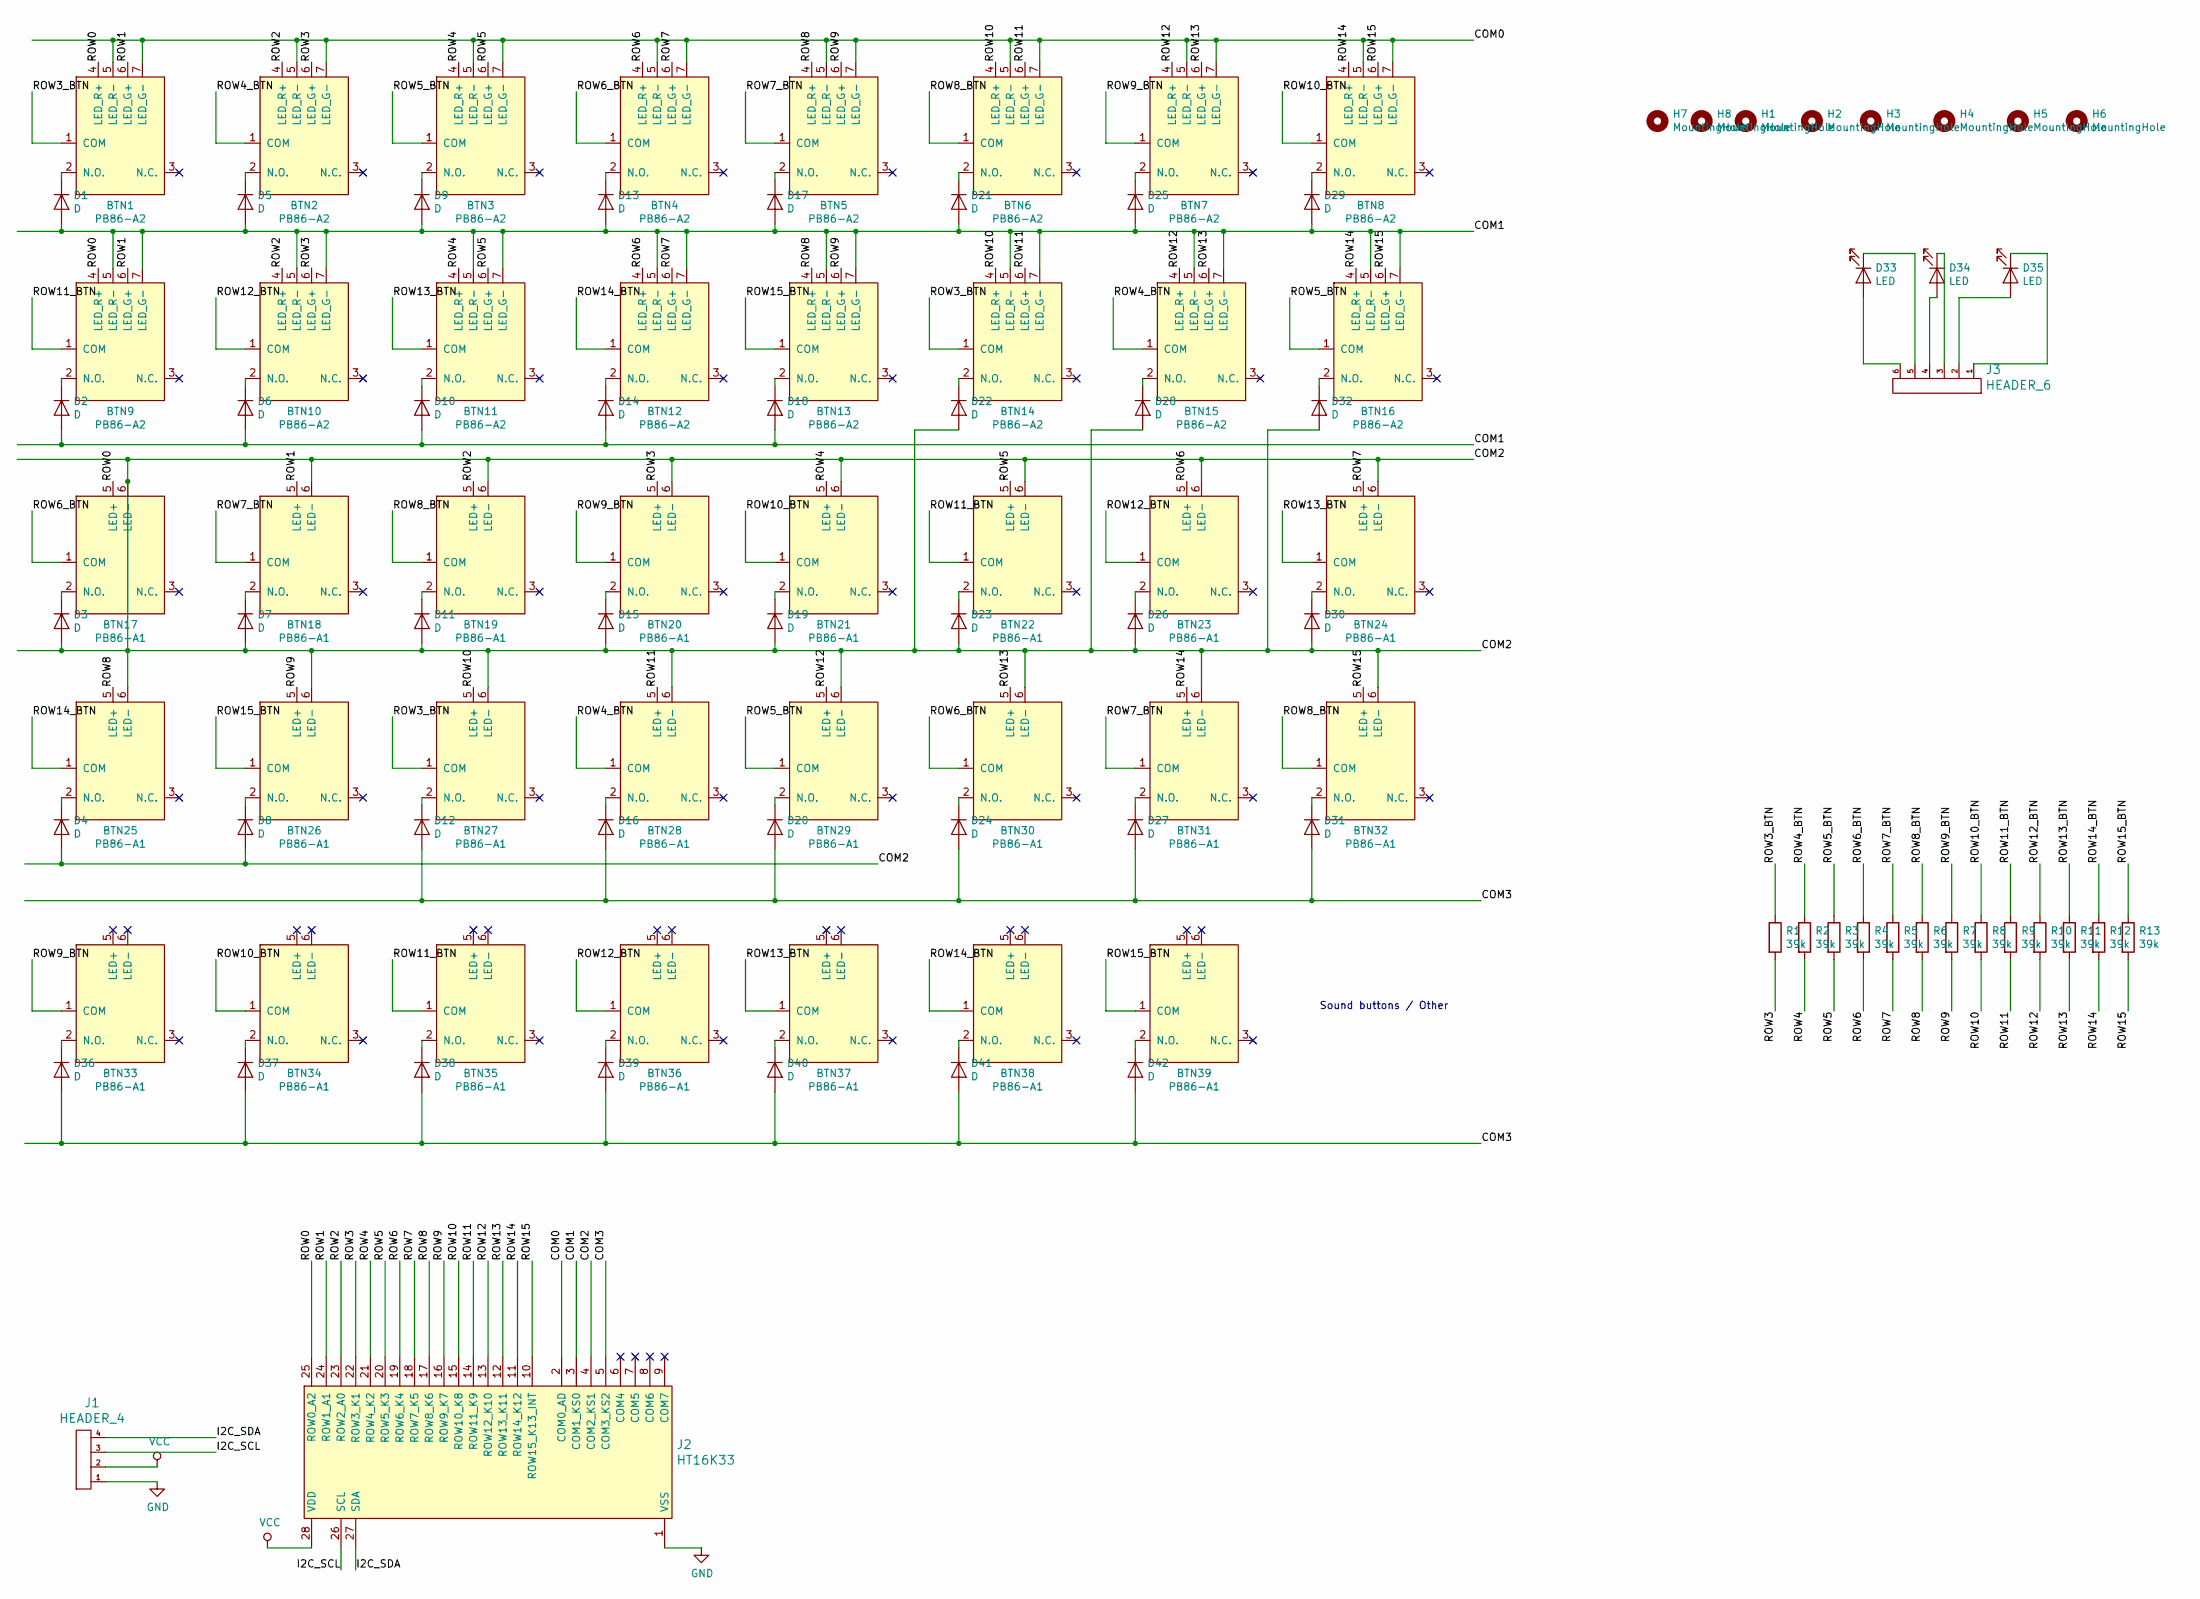
[picture p18: schematic railway_keypad.sch, Ray's Railway Keypad PCB]

Parts:
BTN1, BTN2, BTN3, BTN4, BTN5, BTN6, BTN7, BTN8, BTN9, BTN10, BTN11, BTN12, BTN13, BTN14, BTN15, BTN16: PB86-A2; PB86
BTN17, BTN18, BTN19, BTN20, BTN21, BTN22, BTN23, BTN24, BTN25, BTN26, BTN27, BTN28, BTN29, BTN30, BTN31, BTN32, BTN33, BTN34, BTN35, BTN36, BTN37, BTN38, BTN39: PB86-A1; PB86
D1, D2, D3, D4, D5, D6, D7, D8, D9, D10, D11, D12, D13, D14, D15, D16, D17, D18, D19, D20, D21, D22, D23, D24, D25, D26, D27, D28, D29, D30, D31, D32, D36, D37, D38, D39, D40, D41, D42: D; D_A-405_P10.16mm_Horizontal
D33, D34, D35: LED; LED_D3.0mm
H1, H2, H3, H4, H5, H6, H7, H8: MountingHole; MountingHole_3.2mm_M3
J1: HEADER_4; JST_XH_B4B-XH-A_1x04_P2.50mm_Vertical
J2: HT16K33; DIP-28_W20,32mm
J3: HEADER_6; JST_XH_B6B-XH-A_1x06_P2.50mm_Vertical
R1, R2, R3, R4, R5, R6, R7, R8, R9, R10, R11, R12, R13: 39k; R_Axial_DIN0411_L9.9mm_D3.6mm_P12.70mm_Horizontal

Connections:
/COM0: BTN1.5 (LED_R-), BTN1.7 (LED_G-), BTN2.5 (LED_R-), BTN2.7 (LED_G-), BTN3.5 (LED_R-), BTN3.7 (LED_G-), BTN4.5 (LED_R-), BTN4.7 (LED_G-), BTN5.5 (LED_R-), BTN5.7 (LED_G-), BTN6.5 (LED_R-), BTN6.7 (LED_G-), BTN7.5 (LED_R-), BTN7.7 (LED_G-), BTN8.5 (LED_R-), BTN8.7 (LED_G-), J2.2 (COM0_AD)
/COM1: BTN9.5 (LED_R-), BTN9.7 (LED_G-), BTN10.5 (LED_R-), BTN10.7 (LED_G-), BTN11.5 (LED_R-), BTN11.7 (LED_G-), BTN12.5 (LED_R-), BTN12.7 (LED_G-), BTN13.5 (LED_R-), BTN13.7 (LED_G-), BTN14.5 (LED_R-), BTN14.7 (LED_G-), BTN15.5 (LED_R-), BTN15.7 (LED_G-), BTN16.5 (LED_R-), BTN16.7 (LED_G-), D1.2 (A), D2.2 (A), D5.2 (A), D6.2 (A), D9.2 (A), D10.2 (A), D13.2 (A), D14.2 (A), D17.2 (A), D18.2 (A), D21.2 (A), D25.2 (A), D29.2 (A), J2.3 (COM1_KS0)
/COM2: BTN17.6 (LED-), BTN18.6 (LED-), BTN19.6 (LED-), BTN20.6 (LED-), BTN21.6 (LED-), BTN22.6 (LED-), BTN23.6 (LED-), BTN24.6 (LED-), BTN25.6 (LED-), BTN26.6 (LED-), BTN27.6 (LED-), BTN28.6 (LED-), BTN29.6 (LED-), BTN30.6 (LED-), BTN31.6 (LED-), BTN32.6 (LED-), D3.2 (A), D4.2 (A), D7.2 (A), D8.2 (A), D11.2 (A), D15.2 (A), D19.2 (A), D22.2 (A), D23.2 (A), D26.2 (A), D28.2 (A), D30.2 (A), D32.2 (A), J2.4 (COM2_KS1)
/COM3: D12.2 (A), D16.2 (A), D20.2 (A), D24.2 (A), D27.2 (A), D31.2 (A), D36.2 (A), D37.2 (A), D38.2 (A), D39.2 (A), D40.2 (A), D41.2 (A), D42.2 (A), J2.5 (COM3_KS2)
/I2C_SCL: J1.3, J2.26 (SCL)
/I2C_SDA: J1.4, J2.27 (SDA)
/ROW0: BTN1.4 (LED_R+), BTN9.4 (LED_R+), BTN17.5 (LED+), J2.25 (ROW0_A2)
/ROW1: BTN1.6 (LED_G+), BTN9.6 (LED_G+), BTN18.5 (LED+), J2.24 (ROW1_A1)
/ROW2: BTN2.4 (LED_R+), BTN10.4 (LED_R+), BTN19.5 (LED+), J2.23 (ROW2_A0)
/ROW3: BTN2.6 (LED_G+), BTN10.6 (LED_G+), BTN20.5 (LED+), J2.22 (ROW3_K1), R1.2
/ROW3_BTN: BTN1.1 (COM), BTN14.1 (COM), BTN27.1 (COM), R1.1
/ROW4: BTN3.4 (LED_R+), BTN11.4 (LED_R+), BTN21.5 (LED+), J2.21 (ROW4_K2), R2.2
/ROW4_BTN: BTN2.1 (COM), BTN15.1 (COM), BTN28.1 (COM), R2.1
/ROW5: BTN3.6 (LED_G+), BTN11.6 (LED_G+), BTN22.5 (LED+), J2.20 (ROW5_K3), R3.2
/ROW5_BTN: BTN3.1 (COM), BTN16.1 (COM), BTN29.1 (COM), R3.1
/ROW6: BTN4.4 (LED_R+), BTN12.4 (LED_R+), BTN23.5 (LED+), J2.19 (ROW6_K4), R4.2
/ROW6_BTN: BTN4.1 (COM), BTN17.1 (COM), BTN30.1 (COM), R4.1
/ROW7: BTN4.6 (LED_G+), BTN12.6 (LED_G+), BTN24.5 (LED+), J2.18 (ROW7_K5), R5.2
/ROW7_BTN: BTN5.1 (COM), BTN18.1 (COM), BTN31.1 (COM), R5.1
/ROW8: BTN5.4 (LED_R+), BTN13.4 (LED_R+), BTN25.5 (LED+), J2.17 (ROW8_K6), R6.2
/ROW8_BTN: BTN6.1 (COM), BTN19.1 (COM), BTN32.1 (COM), R6.1
/ROW9: BTN5.6 (LED_G+), BTN13.6 (LED_G+), BTN26.5 (LED+), J2.16 (ROW9_K7), R7.2
/ROW9_BTN: BTN7.1 (COM), BTN20.1 (COM), BTN33.1 (COM), R7.1
/ROW10: BTN6.4 (LED_R+), BTN14.4 (LED_R+), BTN27.5 (LED+), J2.15 (ROW10_K8), R8.2
/ROW10_BTN: BTN8.1 (COM), BTN21.1 (COM), BTN34.1 (COM), R8.1
/ROW11: BTN6.6 (LED_G+), BTN14.6 (LED_G+), BTN28.5 (LED+), J2.14 (ROW11_K9), R9.2
/ROW11_BTN: BTN9.1 (COM), BTN22.1 (COM), BTN35.1 (COM), R9.1
/ROW12: BTN7.4 (LED_R+), BTN15.4 (LED_R+), BTN29.5 (LED+), J2.13 (ROW12_K10), R10.2
/ROW12_BTN: BTN10.1 (COM), BTN23.1 (COM), BTN36.1 (COM), R10.1
/ROW13: BTN7.6 (LED_G+), BTN15.6 (LED_G+), BTN30.5 (LED+), J2.12 (ROW13_K11), R11.2
/ROW13_BTN: BTN11.1 (COM), BTN24.1 (COM), BTN37.1 (COM), R11.1
/ROW14: BTN8.4 (LED_R+), BTN16.4 (LED_R+), BTN31.5 (LED+), J2.11 (ROW14_K12), R12.2
/ROW14_BTN: BTN12.1 (COM), BTN25.1 (COM), BTN38.1 (COM), R12.1
/ROW15: BTN8.6 (LED_G+), BTN16.6 (LED_G+), BTN32.5 (LED+), J2.10 (ROW15_K13_INT), R13.2
/ROW15_BTN: BTN13.1 (COM), BTN26.1 (COM), BTN39.1 (COM), R13.1
GND: J1.1, J2.1 (VSS)
unnamed: BTN1.2 (N.O.), D1.1 (K)
unnamed: BTN2.2 (N.O.), D5.1 (K)
unnamed: BTN3.2 (N.O.), D9.1 (K)
unnamed: BTN4.2 (N.O.), D13.1 (K)
unnamed: BTN5.2 (N.O.), D17.1 (K)
unnamed: BTN6.2 (N.O.), D21.1 (K)
unnamed: BTN7.2 (N.O.), D25.1 (K)
unnamed: BTN8.2 (N.O.), D29.1 (K)
unnamed: BTN9.2 (N.O.), D2.1 (K)
unnamed: BTN10.2 (N.O.), D6.1 (K)
unnamed: BTN11.2 (N.O.), D10.1 (K)
unnamed: BTN12.2 (N.O.), D14.1 (K)
unnamed: BTN13.2 (N.O.), D18.1 (K)
unnamed: BTN14.2 (N.O.), D22.1 (K)
unnamed: BTN15.2 (N.O.), D28.1 (K)
unnamed: BTN16.2 (N.O.), D32.1 (K)
unnamed: BTN17.2 (N.O.), D3.1 (K)
unnamed: BTN18.2 (N.O.), D7.1 (K)
unnamed: BTN19.2 (N.O.), D11.1 (K)
unnamed: BTN20.2 (N.O.), D15.1 (K)
unnamed: BTN21.2 (N.O.), D19.1 (K)
unnamed: BTN22.2 (N.O.), D23.1 (K)
unnamed: BTN23.2 (N.O.), D26.1 (K)
unnamed: BTN24.2 (N.O.), D30.1 (K)
unnamed: BTN25.2 (N.O.), D4.1 (K)
unnamed: BTN26.2 (N.O.), D8.1 (K)
unnamed: BTN27.2 (N.O.), D12.1 (K)
unnamed: BTN28.2 (N.O.), D16.1 (K)
unnamed: BTN29.2 (N.O.), D20.1 (K)
unnamed: BTN30.2 (N.O.), D24.1 (K)
unnamed: BTN31.2 (N.O.), D27.1 (K)
unnamed: BTN32.2 (N.O.), D31.1 (K)
unnamed: BTN33.2 (N.O.), D36.1 (K)
unnamed: BTN34.2 (N.O.), D37.1 (K)
unnamed: BTN35.2 (N.O.), D38.1 (K)
unnamed: BTN36.2 (N.O.), D39.1 (K)
unnamed: BTN37.2 (N.O.), D40.1 (K)
unnamed: BTN38.2 (N.O.), D41.1 (K)
unnamed: BTN39.2 (N.O.), D42.1 (K)
unnamed: D33.1 (K), J3.5
unnamed: D33.2 (A), J3.6
unnamed: D34.1 (K), J3.3
unnamed: D34.2 (A), J3.4
unnamed: D35.1 (K), J3.1
unnamed: D35.2 (A), J3.2
VCC: J1.2, J2.28 (VDD)

Notes on the sheet:
Sound buttons / Other
