chris83527/railway/railway_keypad/railway_keypad.kicad_pcb

## KiCad design railway_keypad/railway_keypad.kicad_pcb (continued)

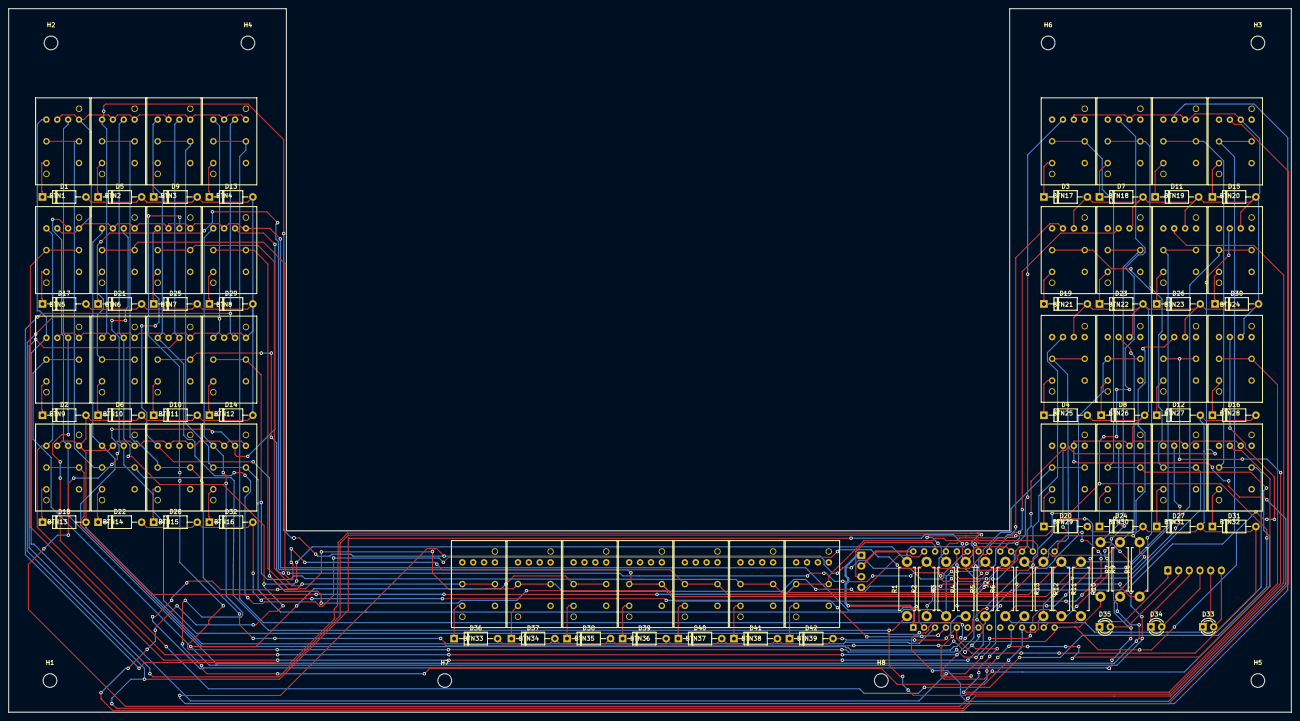
[picture p19: board railway_keypad.kicad_pcb from above]

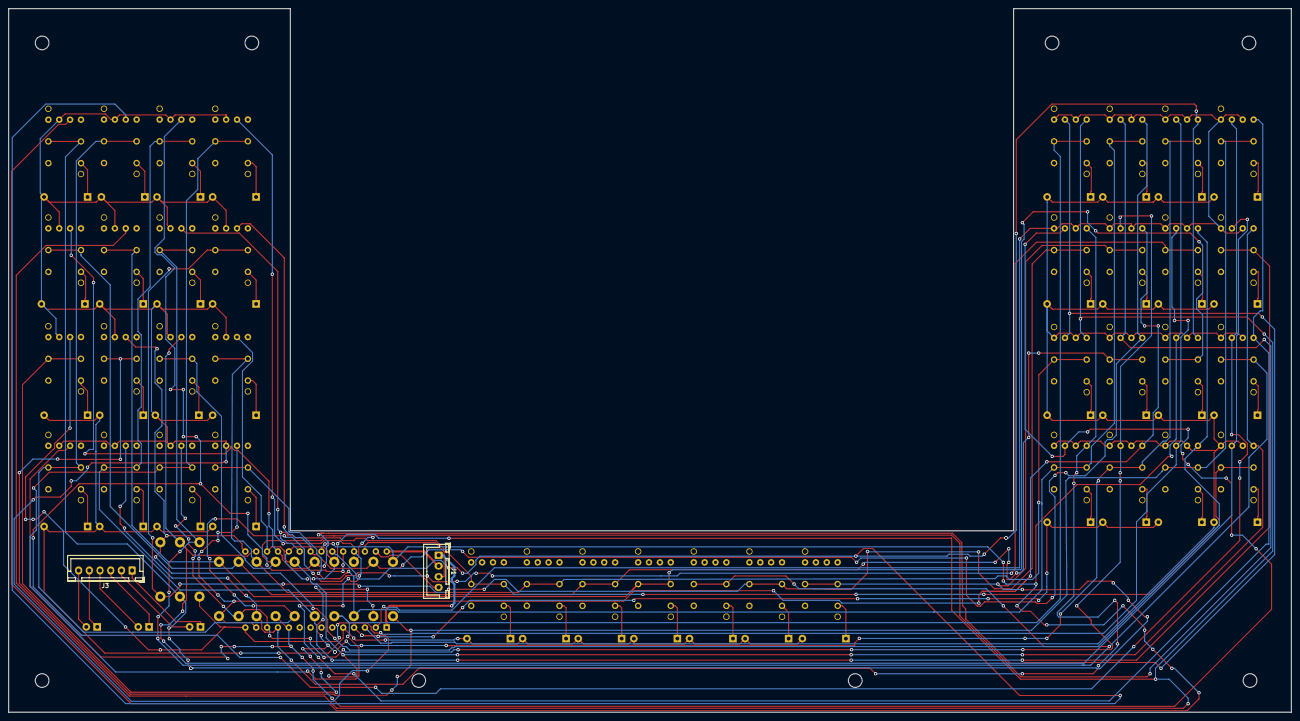
[picture p20: board railway_keypad.kicad_pcb from below]

Board: 2 copper layers, 299.7 x 164.4 mm, 105 parts (2 on the bottom side), 82 nets.
