chris83527/railway/(notices)

Notices in the files:
railway/railway.kicad_pcb:
©2024 Chris Woods
